ChapResearch/ChapR/ChaprSVN/History/Basic Design (4-9-13).jpg

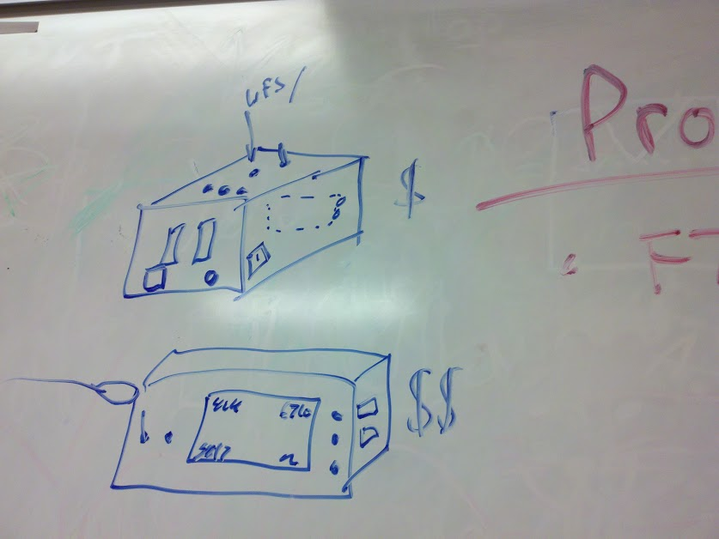
ChaprSVN/History/Basic Design (4-9-13).jpg
