ChapResearch/ChapR/ChaprSVN/Firmware/v1.4 Description.txt

Rachel
	Match mode for FTC
	Match mode for FRC (audio feedback of timing)
	Endgame setting
	Fix autonomous toggling bug (if possible)
	Rewrite FRC packet structure (3 "FF"s)

Coach
	Blinky indication of match mode (out of sync lights)
	Driver database completion (fill in more controller options)
	XBox 360 controller compatibility

*might need to slim down code
