ChapResearch/ChapR/ChaprSVN/Promo/Presentation for FTC.pptx

## The ChapR

Add the kawaii pic from the website

## Slide 2

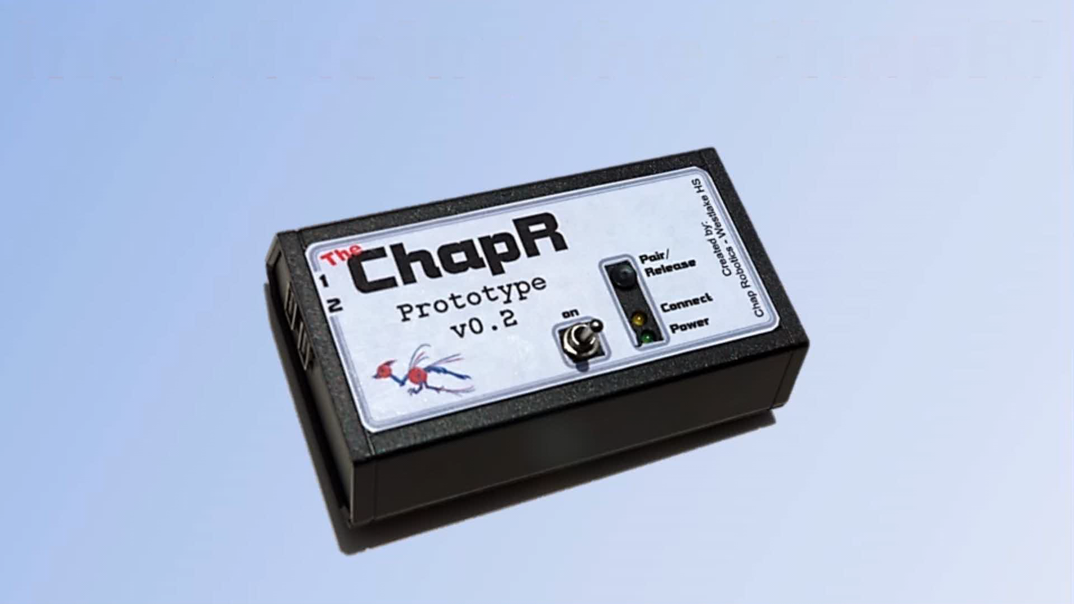
[picture p2: figure]

## Driving

Plug in joysticks

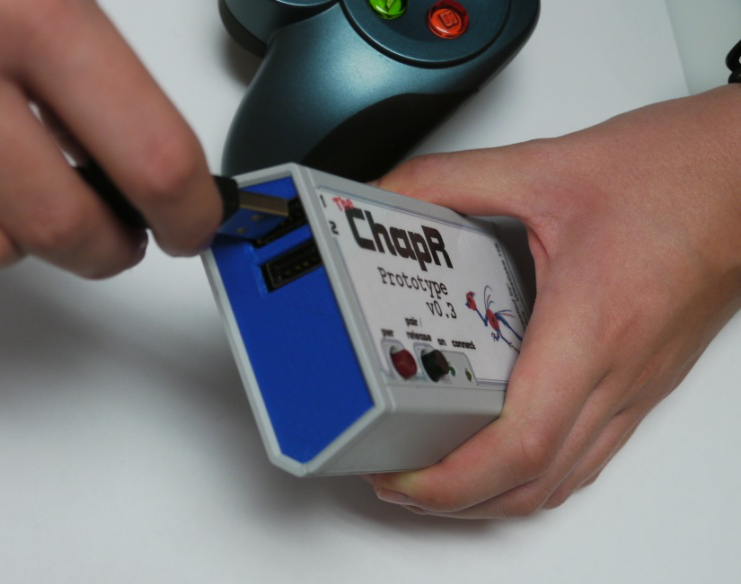
[picture p3: figure]

Hold power button to turn on

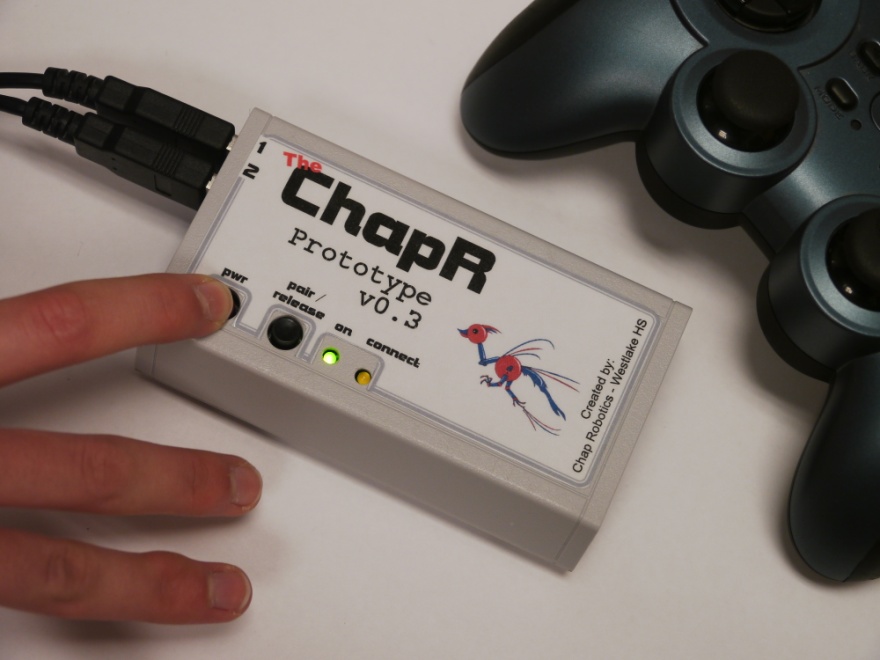
[picture p4: figure]

Hit the WFS button if needed

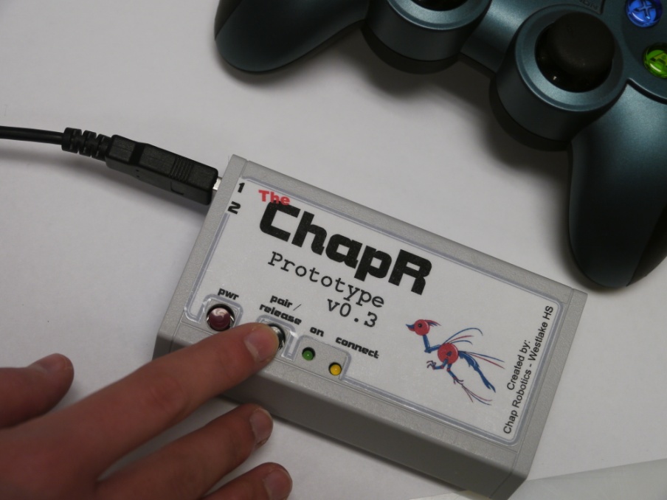
[picture p5: figure]

## The Kill Switch

Tap power button to abort program

TAP

Hold power button to turn off ChapR

HOLD

## Pairing

Via Bluetooth
- Hold down both buttons on the ChapR
- Use NXT menus to find the ChapR and connect with it

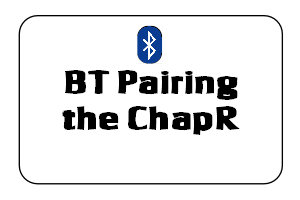
[picture p6: figure]
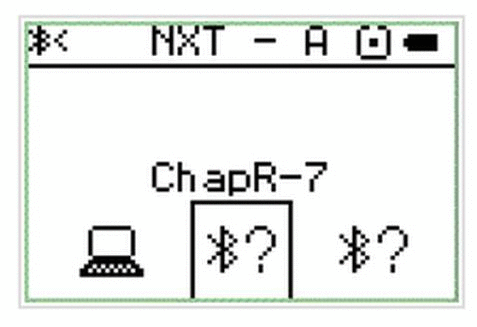
[picture p7: figure]

## Pairing Continued

Via USB
- Make sure Bluetooth is on
- Plug in the cable

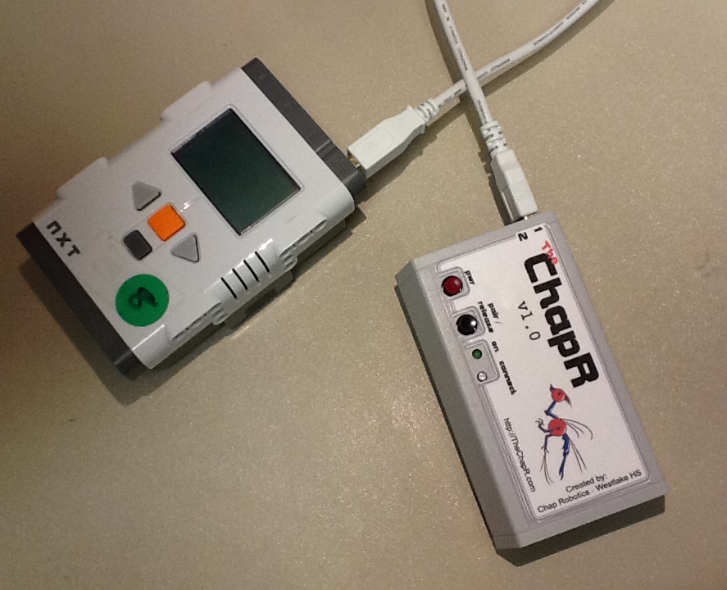
[picture p8: figure]
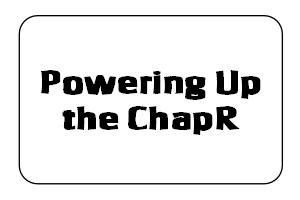
[picture p9: figure]

## Configurable

- name - the name of the ChapR as viewed by devices searching via Bluetooth (usually the NXT); must be under 15 characters; default is ChapR-whichever number ChapR you could (ex: ChapR-14)
- personality - the compatibility of the ChapR; default is 1 (NXT-RobotC); click here to view details
- timeout - the time before the ChapR turns itself off to save battery in minutes; 0 means no timeout; 120 minutes is the maximum; default is 10 minutes
- lag - the time between sending messages; lag can be built in to simulate competition-style driving
- mode - tele-op or autonomous

## Programmable

The programmer and code on our website can be used to reprogram the ChapR

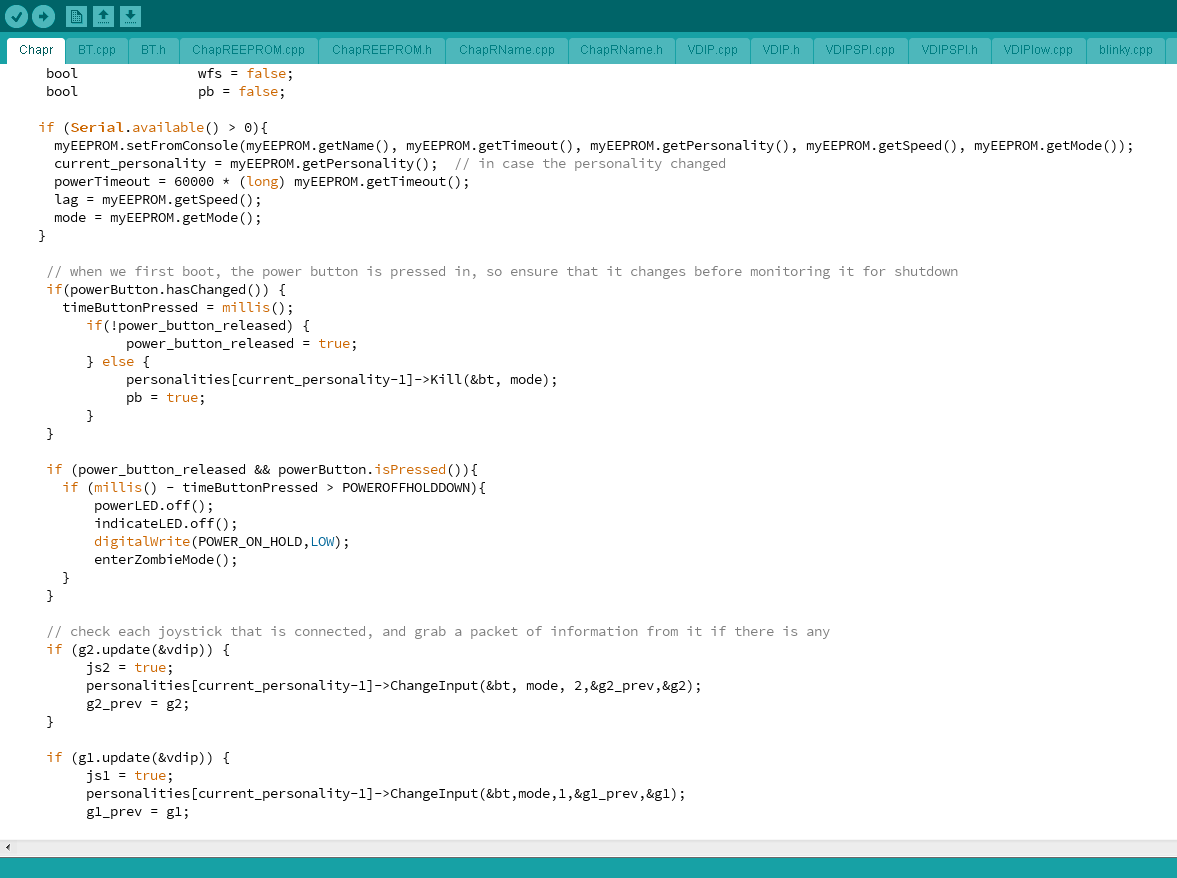
[picture p10: figure]
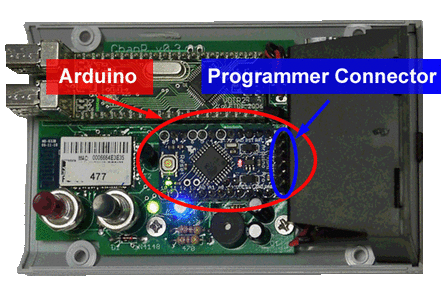
[picture p11: figure]

## The Hardware

USB Interface:
VDIP

Insert flow chart of process and schematic

Arduino Pro-Mini

RN-42

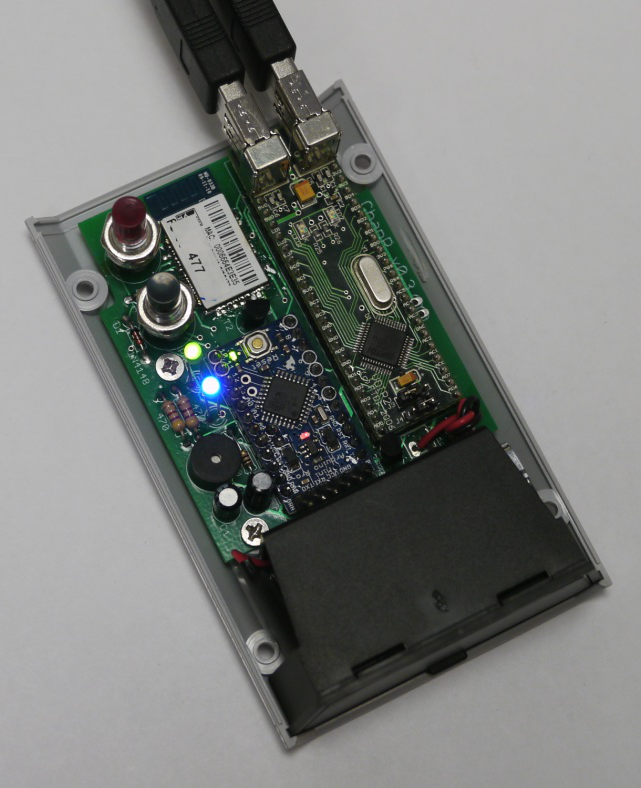
[picture p12: figure]

VDIP

## The Software

- Arduino Sketch written in C

Power Up

Initialize Bluetooth

Set Up

Initialize VDIP

Read EEPROM

## Moving Forward

## Questions? Feedback?

- Any ways to spread the word?
- Advice for manufacturing or production?
- General feedback?
- Uses we didn’t think of?
