ChapResearch/ChapR/ChaprSVN/Case/Labels/Editable Label v2.0.pptx

ChapR

v2.0

action

The

TM

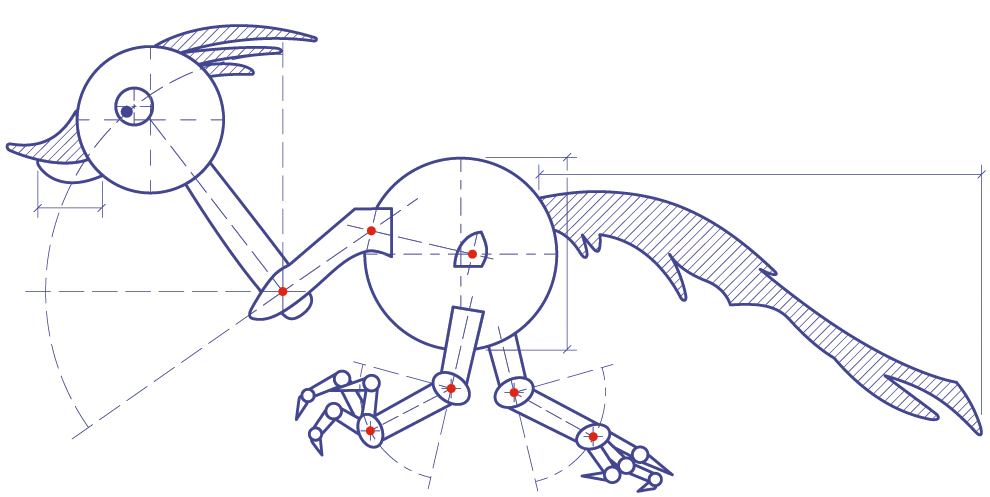
[picture p13: figure]
logo_none_large

http://TheChapR.com

Created by: Chap Research
Patent #9043031

power

on

connect
