ChapResearch/ChapR/ChaprSVN/Firmware/ChapR/Match Cycling Diagram.pptx

Enable match behavior

Power On

Press red button

Kills program

Continues for configured endGame len

Press red button

No Program

Start Auto Program

Press black button

endGame noise

Runs for configured autoLen

Runs for configured teleLen

Tele from FTCConfig.txt starts
