ChapResearch/ChapR/ChaprSVN/PCB/v1.3 Production/Transcode Report.txt

   ---- Transcoding 'C:\Users\Ben\Desktop\Robotics\ChapR\ChapR Code\ChaprSVN\PCB\v1.3 Production\chapr.plc' ----   Mon Aug 18 14:15:53 2014

D10   --> D210
D11   --> D211
D12   --> D212
D13   --> D213
D14   --> D214
D15   --> D215
D16   --> D216
D17   --> D217
D18   --> D218
D19   --> D219
D20   --> D220
D21   --> D221
D22   --> D222
-----------------------------------------------------------------

   ---- Transcoding 'C:\Users\Ben\Desktop\Robotics\ChapR\ChapR Code\ChaprSVN\PCB\v1.3 Production\chapr.sol' ----   Mon Aug 18 14:15:53 2014

D10   --> D223
D11   --> D224
D12   --> D225
D13   --> D226
D14   --> D227
D15   --> D228
D16   --> D229
D17   --> D230
D18   --> D231
D19   --> D232
-----------------------------------------------------------------

   ---- Transcoding 'C:\Users\Ben\Desktop\Robotics\ChapR\ChapR Code\ChaprSVN\PCB\v1.3 Production\chapr.stc' ----   Mon Aug 18 14:15:53 2014

D10   --> D233
D11   --> D234
D12   --> D235
D13   --> D236
D14   --> D237
D15   --> D238
D16   --> D239
D17   --> D240
D18   --> D241
D19   --> D242
D20   --> D243
-----------------------------------------------------------------

   ---- Transcoding 'C:\Users\Ben\Desktop\Robotics\ChapR\ChapR Code\ChaprSVN\PCB\v1.3 Production\chapr.sts' ----   Mon Aug 18 14:15:53 2014

D10   --> D244
D11   --> D245
D12   --> D246
D13   --> D247
D14   --> D248
D15   --> D249
D16   --> D250
D17   --> D251
D18   --> D252
-----------------------------------------------------------------

   ---- Transcoding 'chapr.plc' ----   Mon Aug 18 14:18:10 2014

D10   --> D253
D11   --> D254
D12   --> D255
D13   --> D256
D14   --> D257
D15   --> D258
D16   --> D259
D17   --> D260
D18   --> D261
D19   --> D262
D20   --> D263
D21   --> D264
D22   --> D265
-----------------------------------------------------------------

   ---- Transcoding 'chapr.sol' ----   Mon Aug 18 14:18:10 2014

D10   --> D266
D11   --> D267
D12   --> D268
D13   --> D269
D14   --> D270
D15   --> D271
D16   --> D272
D17   --> D273
D18   --> D274
D19   --> D275
-----------------------------------------------------------------

   ---- Transcoding 'chapr.stc' ----   Mon Aug 18 14:18:10 2014

D10   --> D276
D11   --> D277
D12   --> D278
D13   --> D279
D14   --> D280
D15   --> D281
D16   --> D282
D17   --> D283
D18   --> D284
D19   --> D285
D20   --> D286
-----------------------------------------------------------------

   ---- Transcoding 'chapr.sts' ----   Mon Aug 18 14:18:10 2014

D10   --> D287
D11   --> D288
D12   --> D289
D13   --> D290
D14   --> D291
D15   --> D292
D16   --> D293
D17   --> D294
D18   --> D295
-----------------------------------------------------------------
