ChapResearch/ChapR/ChaprSVN/Case/Labels/Label v2.0 (x8).pdf

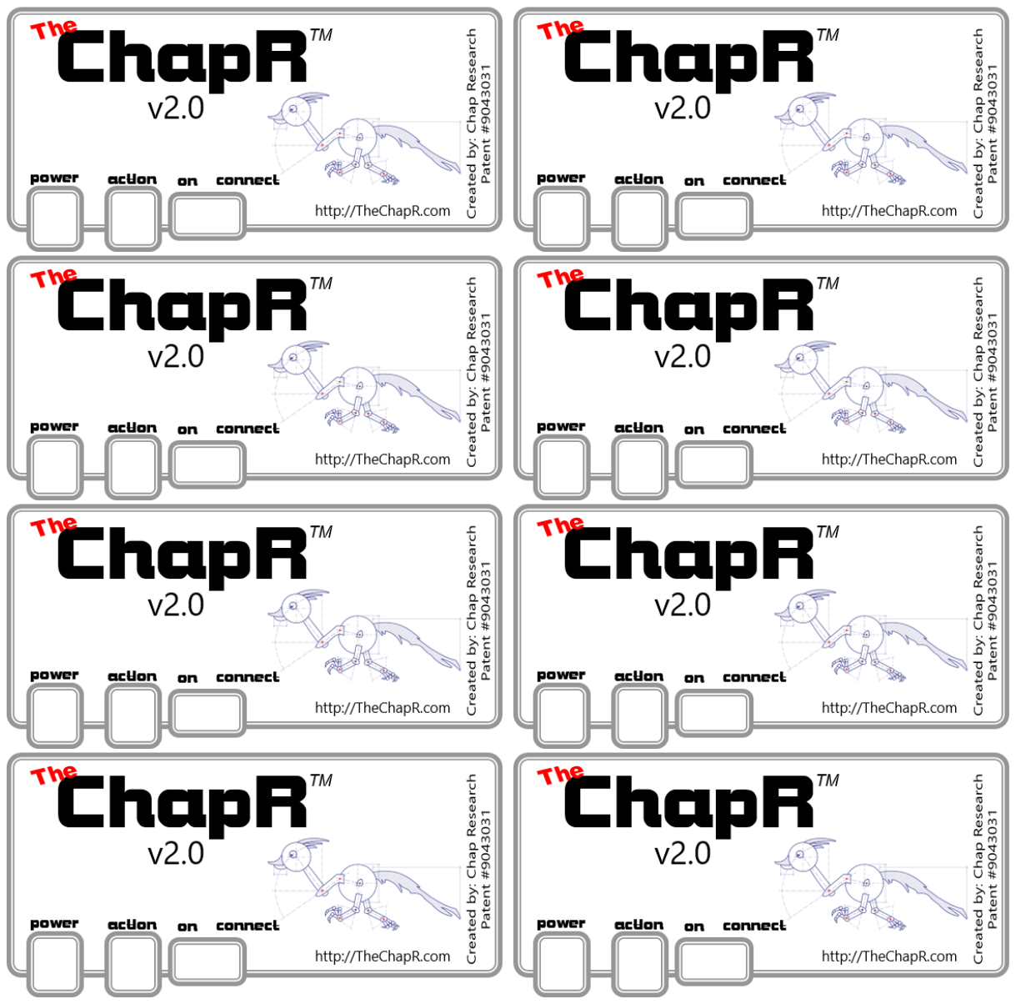
[picture p14: page 1]
