ChapResearch/ChapR/ChaprSVN/PCB/v1.2 Production/Transcode Report.txt

   ---- Transcoding 'C:\Users\Ben\Desktop\Robotics\ChapR\ChapR Code\ChaprSVN\PCB\v1.2 Production\chapr.plc' ----   Tue Mar 18 17:31:22 2014

D10   --> D100
D11   --> D101
D12   --> D102
D13   --> D103
D14   --> D104
D15   --> D105
D16   --> D106
D17   --> D107
D18   --> D108
D19   --> D109
D20   --> D110
D21   --> D111
D22   --> D112
-----------------------------------------------------------------

   ---- Transcoding 'C:\Users\Ben\Desktop\Robotics\ChapR\ChapR Code\ChaprSVN\PCB\v1.2 Production\chapr.sol' ----   Tue Mar 18 17:31:22 2014

D10   --> D113
D11   --> D114
D12   --> D115
D13   --> D116
D14   --> D117
D15   --> D118
D16   --> D119
D17   --> D120
D18   --> D121
D19   --> D122
D20   --> D123
-----------------------------------------------------------------

   ---- Transcoding 'C:\Users\Ben\Desktop\Robotics\ChapR\ChapR Code\ChaprSVN\PCB\v1.2 Production\chapr.stc' ----   Tue Mar 18 17:31:22 2014

D10   --> D124
D11   --> D125
D12   --> D126
D13   --> D127
D14   --> D128
D15   --> D129
D16   --> D130
D17   --> D131
D18   --> D132
D19   --> D133
D20   --> D134
D21   --> D135
-----------------------------------------------------------------

   ---- Transcoding 'C:\Users\Ben\Desktop\Robotics\ChapR\ChapR Code\ChaprSVN\PCB\v1.2 Production\chapr.sts' ----   Tue Mar 18 17:31:22 2014

D10   --> D136
D11   --> D137
D12   --> D138
D13   --> D139
D14   --> D140
D15   --> D141
D16   --> D142
D17   --> D143
D18   --> D144
D19   --> D145
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

D10   --> D124
D11   --> D125
D12   --> D126
D13   --> D127
D14   --> D128
D15   --> D129
D16   --> D130
D17   --> D131
D18   --> D132
D19   --> D133
D20   --> D134
D21   --> D135
-----------------------------------------------------------------

   ---- Transcoding 'C:\Users\Ben\Desktop\Robotics\ChapR\ChapR Code\ChaprSVN\PCB\v1.2 Production\chapr.sts' ----   Tue Mar 18 17:36:02 2014

D10   --> D136
D11   --> D137
D12   --> D138
D13   --> D139
D14   --> D140
D15   --> D141
D16   --> D142
D17   --> D143
D18   --> D144
D19   --> D145
-----------------------------------------------------------------
