ChapResearch/ChapR/ChaprSVN/Case/Labels/Label 2.0.png

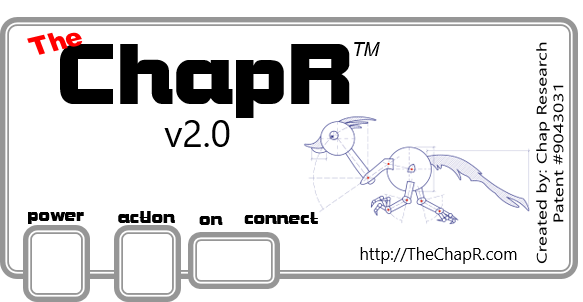
ChaprSVN/Case/Labels/Label 2.0.png
