ChapResearch/ChapR/ChaprSVN/PCB/chapr11-page-001.jpg

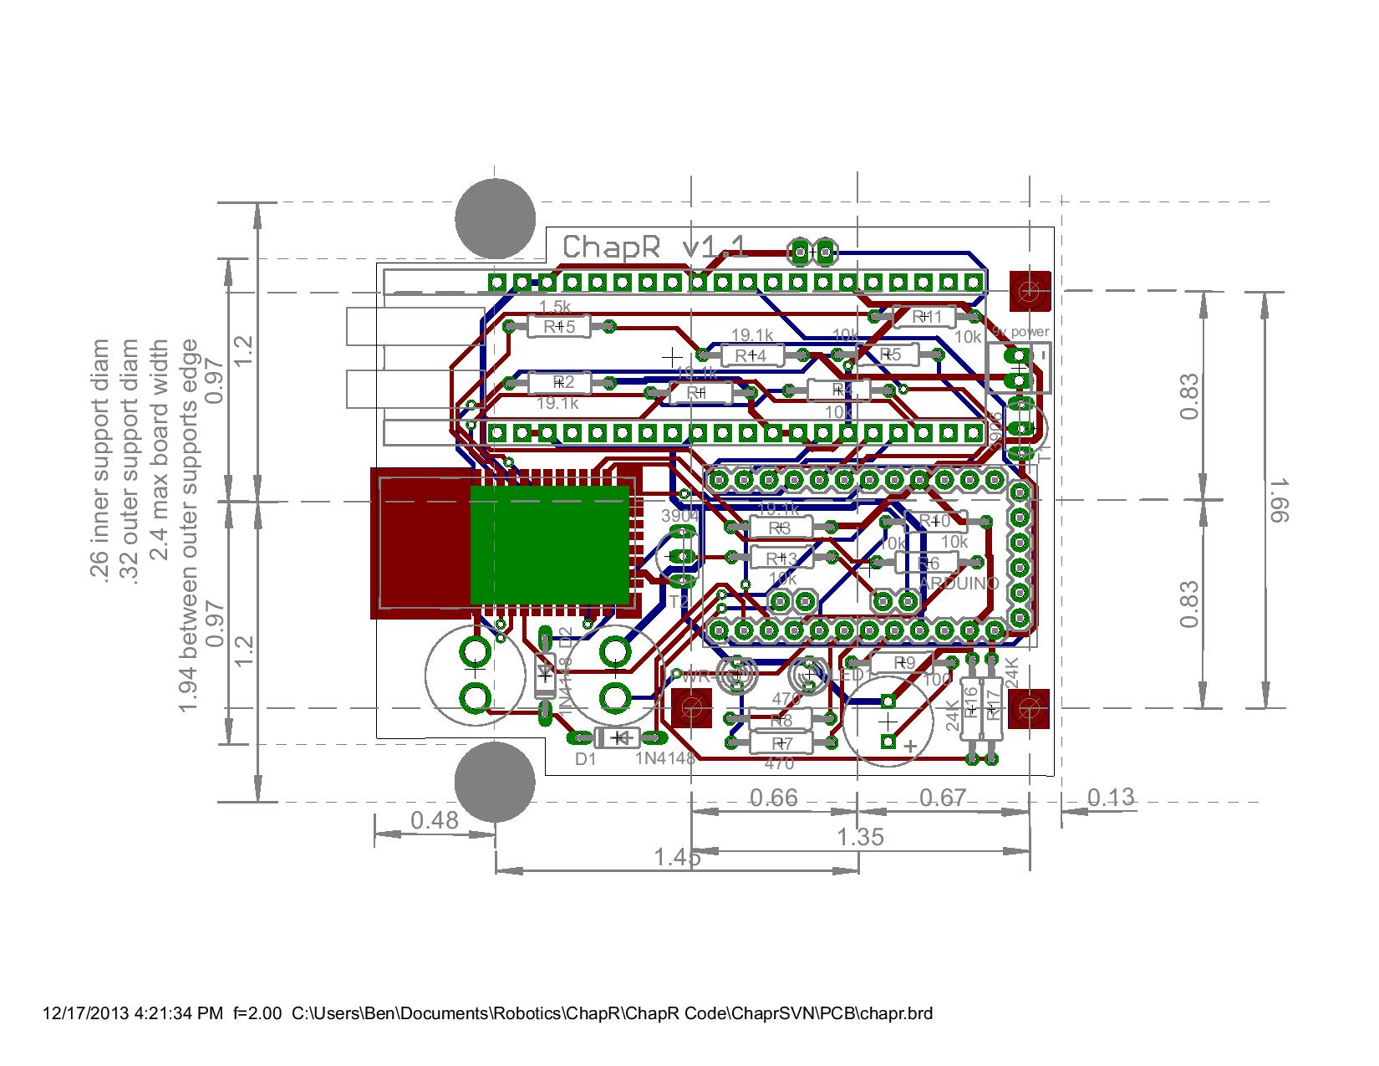
ChaprSVN/PCB/chapr11-page-001.jpg
