ChapResearch/ChapR/ChaprSVN/PCB/chaprsch-page-001.jpg

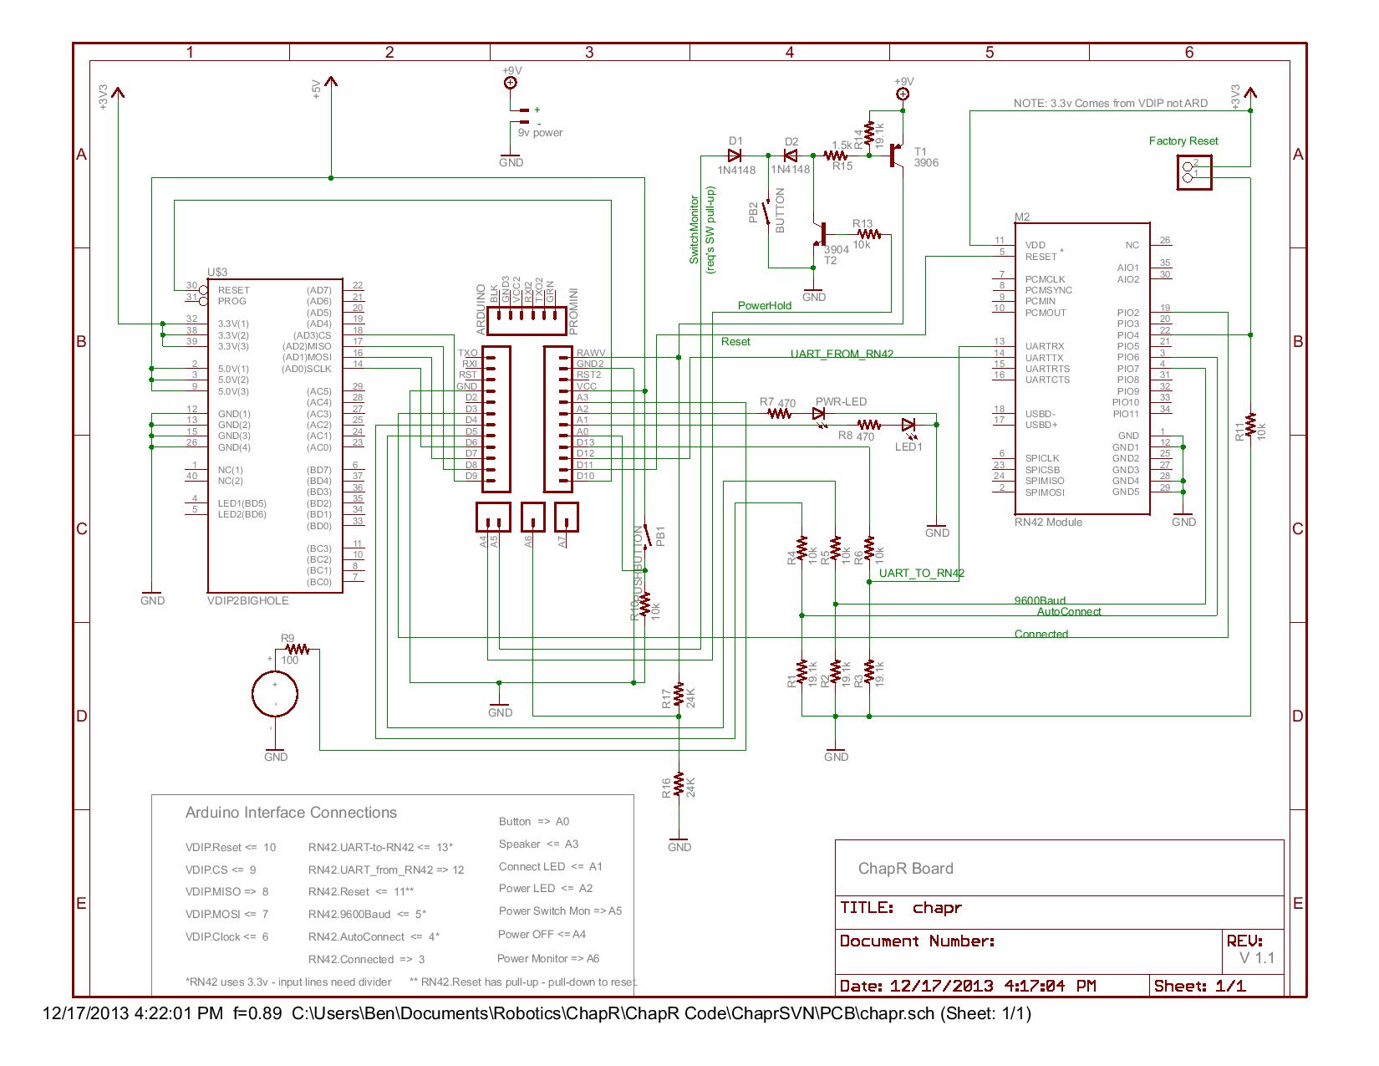
ChaprSVN/PCB/chaprsch-page-001.jpg
