ChapResearch/ChapR/ChaprSVN/History/Inventory.txt

ChapR-5 (1st Button Board)
**needs a lid
yellow and green LEDs
v0.3 board
v1.0 software

ChapR-6 (VHS Board)
**needs to be signed
yellow and green LEDs
v0.3 board
v1.0 software

ChapR-7 (Ben Board)
**has lid with green marks
**battery connector came off
blue and green LEDs
v0.3 board
v1.0 software (w/ board bring-up)

ChapR-8 (Ben Board 2)
**has lid without sticker
**needs to be signed
9V battery connector tied off
blue and green LEDs
v.03 board
v1.0 software (w/ board bring-up)

ChapR-9 (Everybody board)
***NOT WORKING
