ChapResearch/ChapR/ChaprSVN/Reference/ChapR parts list.docx

ChapR parts list

- VDIP2 - $27.05 - http://www.mouser.com/ProductDetail/FTDI/VDIP2/?qs=sGAEpiMZZMtS2C%252bP%252bIdbt5oBzQFVRQxbtDiAvH1hspo%3d
- Roving Networks Bluetooth Module 42 - $15.95 - https://www.sparkfun.com/products/10253
- Arduino MINI - $9.95 - https://www.sparkfun.com/products/11113
- 2 Red LEDs -
- Speaker -
- 9V battery – not included
- Battery connector - $1.13 – https://www.sparkfun.com/products/91
- Solder – not included
- ChapR board - $20 – chapr.weebly.com
- Button – $0.35 - mini push button switch
- 11 resistors – 20 at $0.95 – https://www.sparkfun.com/products/11852
- Switch – $0.45 – https://www.sparkfun.com/products/10727
