ChapResearch/ChapR/ChaprSVN/Manufacturing/PriceSourceList v3 Release.xlsx

QTY | Part Name | Cost | Total | Mouser | Radio Shack | BG Micro | Spark Fun | Digikey | Notes
1 | VDIP2 | $27.05 | $27.05 | 895-VDIP2 |  |  |  | 768-1002-ND
1 | RN42 | 15.95 | $15.95 | 765-RN-42 |  |  | WRL-10253 | 740-1038-ND | - digikey price for 10 matches sparkfun
1 | Arduino Pro MINI | 8.96 | $8.96 |  |  |  | DEV-11113
1 | Green LED | 0.09 | $0.09 | 604-WP710A10PGD
1 | Blue LED | 0.78 | $0.78 | 604-WP710A10MBD
1 | Speaker | 0.30 | $0.30 |  |  | AUD1080
1 | 9V battery - lithium 1200mAh | 6.80 | $6.80 | 5169-U9VL-X |  |  |  |  | - minimum at Mouser is 31 - $6.00 at Battery Junction (+shipping)
1 | 9V battery snap | 0.25 | $0.25 | 121-0426/I-GR |  |  | PRT-00091 |  | - much cheaper at mouser as opposed to spark fun
1 | ChapR board | 7.00 | $7.00 |  |  |  |  |  | - current estimate
1 | Button - red cap | 0.99 | $0.99 | 112-R13-24A-BR
1 | Button - black cap | 0.99 | $0.99 | 112-R13-24A-BB | 275-1547 |  |  |  | - same exact switch - RS is cheaper for singles
4 | 19.1 kΩ resistor | 0.07 | $0.28 | 71-RN55D1912F
7 | 10 kΩ resistor | 0.02 | $0.13 | 291-10K-RC
1 | 100Ω resistor | 0.07 | $0.07 | 291-100-RC
2 | 470Ω resistor | 0.07 | $0.14 | 291-470-RC
2 | 24 kΩ resistor | 0.02 | $0.04 | 291-24k-RC
1 | 1.5 kΩ resistor | 0.02 | $0.02 | 291-1.5k-RC
1 | Case - Serpac A21 (black) | 3.85 | $3.85 | 635-A-21-B |  |  |  | SRA21B-ND
1 | Case - Serpac 9v holder | 0.80 | $0.80 | 635-2006-9V |  |  |  | SRA21-9VBK-ND
1 | 2N3904 transistor | 0.10 | $0.10 | 512-2N3904BU |  |  |  |  | - TO-92 EBC - at 100 quantity, $0.056, bulk
1 | 2N3906 transistor | 0.06 | $0.06 | 512-2N3906BU |  |  |  |  | - TO-92 EBC - at 100 quantity, $0.057, bulk
2 | diode | 0.10 | $0.20 | 583-1N4148-B
1 | misc (headers, label…) | 0.20 | $0.20
3 | screws to hold down board | 0.04 | $0.12 |  |  |  |  |  | - FMW part 1556.440316.188, 4-40 x 3/16 Phillips Pan Machine Screw 18-8 SS
1 | shipping box | 0.55 | $0.55 |  |  |  |  |  | - Office Depot #699328
1 | (opt) cable for NXT | 0.74 | $0.74 | 538-88732-9002 |  |  | CAB-00512 |  | - standard A to B USB cable - monoprice.com
 | (opt) arduino programmer | 14.95 | $0.00 |  |  |  | DEV-09716
 |  |  | $76.46
Notes:
 | - taxes/shipping aren't included in these prices
 | - costs are calculated on a minimum purchase of 10
 | - listed cost is the cheapest of all sources
 | - case price is for the black version - the grey version is $2 cheaper!
 | - costs for transistors/resistors/diodes are based upon purchase of 100
