ChapResearch/ChapR/ChaprSVN/Case/CaseDrillTemplate/template v1.SLDPRT

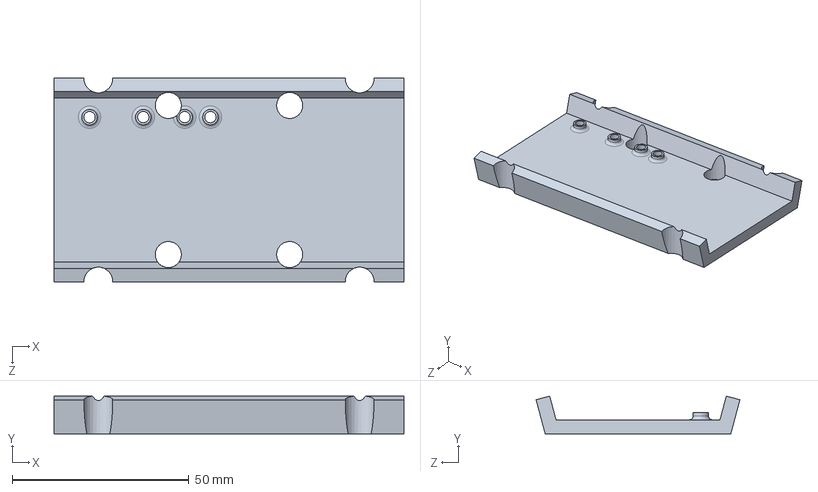
[picture p18: CAD file, 2015-04-01]
ChaprSVN/Case/CaseDrillTemplate/template v1.SLDPRT
99.0 x 10.7 x 57.7 mm
