ChapResearch/ChapR/ChaprSVN/Construction Instructions (for customers).docx

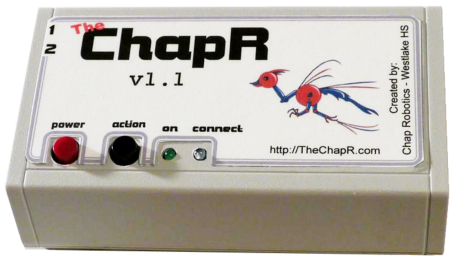
[picture p22: figure]
v1
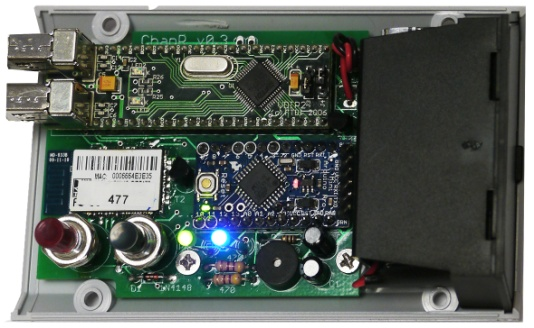
[picture p23: figure]

| ChapR Manufacturing Instructions N S N S v1.3 PCB May 8th, 2014

Name: | | | Date: | | | ChapR #:

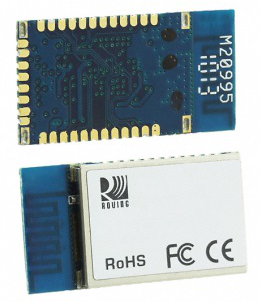
[picture p24: figure]

# 1. PCB – RN-42

Soldering the RN-42 is one of the most key things for creating a ChapR. The pins are VERY close together and need to be lined-up perfectly with the PCB. NOTE: This step has likely already been done for you.

☐ | 1.1. Tin the bottom pads of the RN-42 – wick afterwards to ensure no shorts.
☐ | 1.2. Used double-sided tape on the bottom of the RN-42, so you can position it on the pads on the PCB. Ensure perfect positioning!
☐ | 1.3. Solder one pad to lock-down the RN-42.
☐ | 1.4. Re-inspect for perfect positioning. If not, redo the previous step.
☐ | 1.5. Solder all other pads, using wick if necessary to remove shorts.
☐ | 1.6. After finishing the RN-42, test using voltmeter to find shorts.

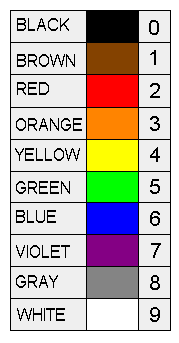
[picture p25: figure]

# 2. PCB – Resistors

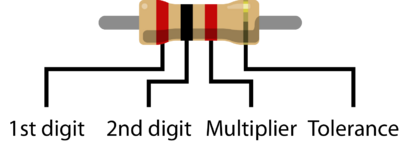
[picture p26: figure]
400px-Resistor_color_code_chart_mod

☐ | 2.1. Place resistors on top of PCB – ensure that they are flat.
☐ | 2.2. Solder from top of board.
☐ | 2.3. Inspect all solder joints.
☐ | 2.4. Clip leads.

# 3. PCB –Diodes

☐ | 3.1. Place diodes on top of PCB – ensure that they are flat and LINED UP correctly. The lines must match the PCB illustration.

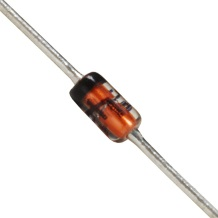
[picture p27: figure]

☐ | 3.2. Solder from top of PCB. Line
☐ | 3.3. Inspect all solder joints.
☐ | 3.4. Clip leads.

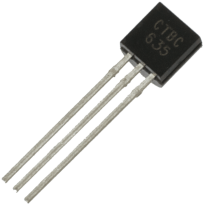
[picture p28: figure]

# 4. PCB – Transistors

3906

3904

☐ | 4.1. Two transistors are mounted from top of PCB – note positioning of 3906 and 3904. Insert as indicated on the PCB and press down to position about ¼ inch above PCB.
☐ | 4.2. Bend one pin at the bottom of PCB to keep in place and solder from bottom, the other two pins.
☐ | 4.3. Un-bend the other pin and solder it.
☐ | 4.4. Inspect all solder joints.
☐ | 4.5. Clip leads.

# 5. PCB – Arduino Preparation

The Arduino is first “prepared” before it is soldered. This consists of soldering the pins to the Arduino board but NOT soldering it to the PCB yet. The PCB is used, however, as the line-up mechanism for the pins for the Arduino board.

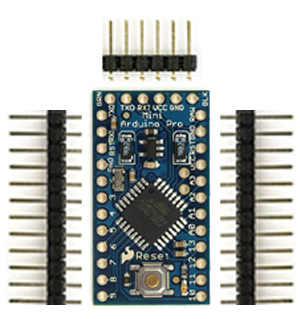
[picture p29: figure]

☐ | 5.1. Place two 12-pin headers on PCB in appropriate positions for Arduino with the long pins of the header in the PCB.

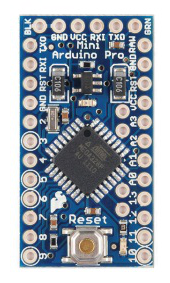
[picture p30: figure]

☐ | 5.2. Place two 2-pin header in the positions marked XXXXX on the PCB with the long pins of the header in the PCB. This matches the two holes on the Arduino close to VCC/A3/A2.
☐ | 5.3. Orient and place the Arduino, face up, on top of the pins and solder all headers to the Arduino.
☐ | 5.4. Inspect all solder joints.
☐ | 5.5. Remove Arduino from PCB and insert 6-pin header ON TOP of Arduino – the short pins of the header go into the Arduino board.
☐ | 5.6. Place Arduino upside-down on table, allowing 6-pin header to flare outwards. Solder the 6-pin header from the bottom of the Arduino.

# 6. PCB – Arduino Installation

☐ | 6.1. Place the prepared Arduino on the PCB, pushing it down onto the board as flush as possible.
☐ | 6.2. While holding the Arduino flush, solder two opposite corner pins on the Arduino from the bottom of the PCB – to keep it flush.
☐ | 6.3. Solder all remaining pins.
☐ | 6.4. Inspect all solder joints.

# 7. PCB – VDIP

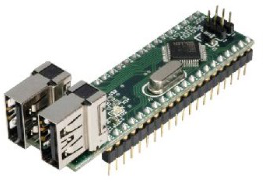
[picture p31: figure]

☐ | 7.1. Insert the VDIP into the PCB. Top Jumper
☐ | 7.2. While holding the VDIP as flush as possible to the PCB, bend down two corner pins under the PCB to lock the VDIP in place. Then ensure that it is flush to the PCB.
☐ | 7.3. Solder all remaining other (non-bent) pins.
☐ | 7.4. Unbend and solder the two corner pins.
☐ | 7.5. Inspect all solder joints.
☐ | 7.6. Move the top jumper to the other two pins.

# 8. PCB – Buttons

☐ | 8.1. Mount the power button (red) and bend the flanges to be flush with the bottom of the PCB (placement direction doesn’t matter).
☐ | 8.2. Solder the button to the PCB using a significant amount of solder
☐ | 8.3. Mount the action button (black) and bend the flanges to be flush with the bottom of the PCB (placement direction doesn’t matter).
☐ | 8.4. Solder the button to the PCB using a significant amount of solder.

# 9. PCB – Speaker

☐ | 9.1. Check the backside of the speaker for the plus sign and line it up with the plus sign on the board.
☐ | 9.2. Bend one pin on the back to hold it in place and solder the other pin from the bottom.
☐ | 9.3. Bend the pin back and solder, clip.

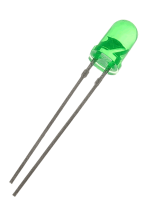
[picture p32: figure]

# 10. PCB – LEDs

Short
Node

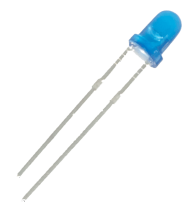
[picture p33: figure]

Identify the long lead of each LED – this is the positive lead. If the LED leads have been cut, the long lead side can be determined by finding the short node inside the LED.

Long Lead

☐ | 10.1. Starting with the green LED, insert it next to the black button with the positive side South (long lead). Line up the top of the LED to the top of the black button when pressed, and bend the long lead so that the LED hangs at the right height when the PCB is upside down. Solder the short lead.
☐ | 10.2. Unbend the long lead and go back to the top side of the PCB and ensure that the LED is aligned to the center of the buttons.
☐ | 10.3. Solder the long lead.
☐ | 10.4. Insert the blue LED with the long lead South, bending the long lead to allow the blue LED to hang at the same height as the green LED. Solder the short lead.
☐ | 10.5. Unbend the long lead and go back to the top side of the PCB and ensure that the LED is aligned to the center of the buttons.
☐ | 10.6. Solder the long lead.
☐ | 10.7. Clip leads

# 11. PCB – 9V Snap

☐ | 11.1. Tin the wires to stiffen them.
☐ | 11.2. Insert and bend opposite ways. BLACK IS NEGATIVE.
☐ | 11.3. Solder to board, making sure that black is lined up with minus sign and it sticks up above the board.

May 8th, 2014 ChapR Manufacturing Instructions Page 1 of 4 v1.3 PCB
