ChapResearch/ChapR/ChaprSVN/History/FCS Operations (4-12-13).docx

FCS Operations

1. All 3 rBricks on and connected to their respective ChapRs
2. Connect your rBrick to the ChapFCS (same way as ChapR)
3. LCD says “Connect to other ChapRs”
4. ChapRs hold down the button to make their ChapRs discoverable
5. ChapFCS selects ChapRs on LCD screen
