ChapResearch/ChapR/ChaprSVN/Test Data/LagResearch v1.xlsx

180 | 1 joystick plugged in |  |  | no stick activity
lag | count | notes | per sec | delay ms
0 | 8292 |  | 46.1 | 21.70767004
10 | 5680 |  | 31.6 | 31.69014085
25 | 3860 |  | 21.4 | 46.63212435
50 | 2516 |  | 14.0 | 71.54213037
100 | 1481 |  | 8.2 | 121.5395003
150 | 1049 |  | 5.8 | 171.5919924
200 | 814 |  | 4.5 | 221.1302211
250 | 664.2066421 |  | 3.7 | 271 | extrapolated
