ChapResearch/ChapR/ChaprSVN/Test Data/lagGraph.png

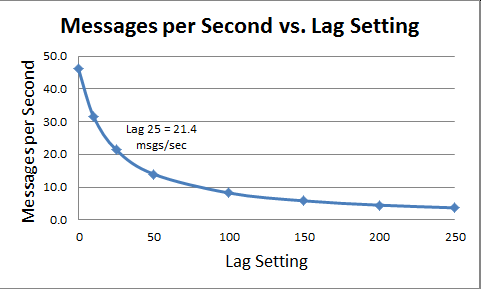
ChaprSVN/Test Data/lagGraph.png
