ChapResearch/ChapR/ChaprSVN/History/Website Progress.docx

Questionable Changes to the Website

- Took out the pages under “Get Started!” and replaced them with ChapR and ChapFCS

ChapFCS Stuff to be Added Later

- Pictures under the picture gallery
- FAQS Questions on the added functionality of the ChapFCS such as setting up a match, adding the lag, running autonomous etc.
  - How do I set up a match?
  - How do I kick someone out of a match?
  - How do I add the lag to our match?
- Repairs
- Updates
- Buy It

The full ChapR model, the ChapFCS has all the features you need to simulate the field at competition:

- Toggled lag feature (lag simulates the poor wi-fi connection at competitions)
- Simulates the Field Control System (one robot on ChapR model, up to three on ChapRs linked to the ChapFCS)
- Displays connected teams on the LCD
- All the features included in the ChapR

Assignment 1

Upon boot it prompts the user to hit return if you want to rename it

Prints current name “ChapR-new”

Accepts a String from the user followed by a return and sets the name

Can be anything except ChapR-1

Requests a yes or no to confirm

If no, return

If yes, reboot

eeprom
