ChapResearch/ChapR/ChaprSVN/PCB/chapr11.pdf

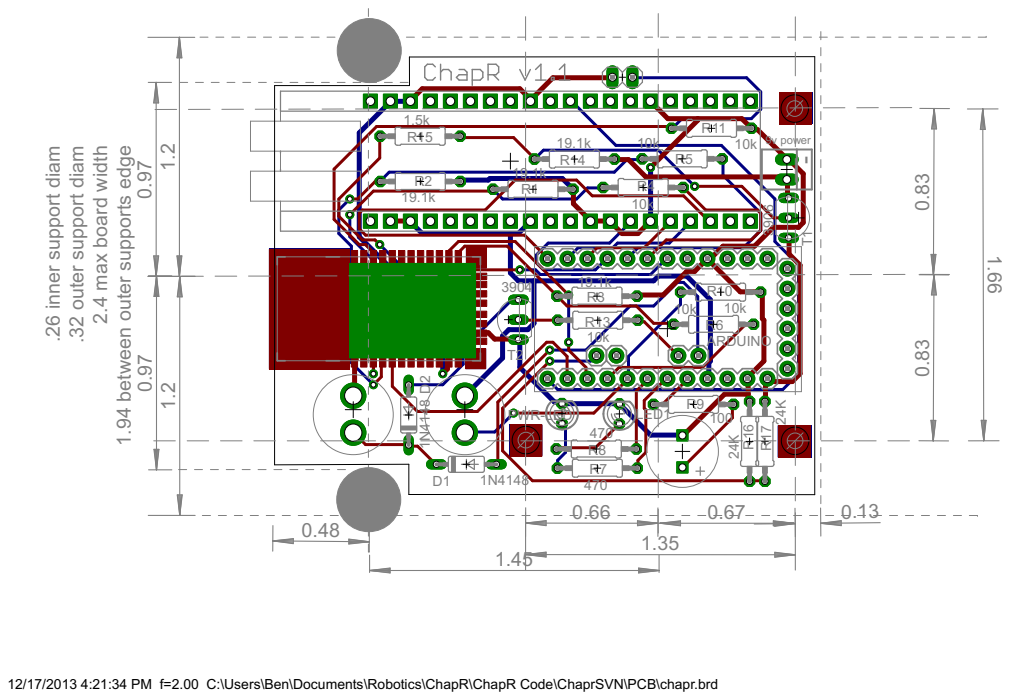
[picture p35: page 1]

12/17/2013 4:21:34 PM f=2.00 C:\Users\Ben\Documents\Robotics\ChapR\ChapR Code\ChaprSVN\PCB\chapr.brd
