ChapResearch/ChapR/ChaprSVN/PCB/chaprsch.pdf

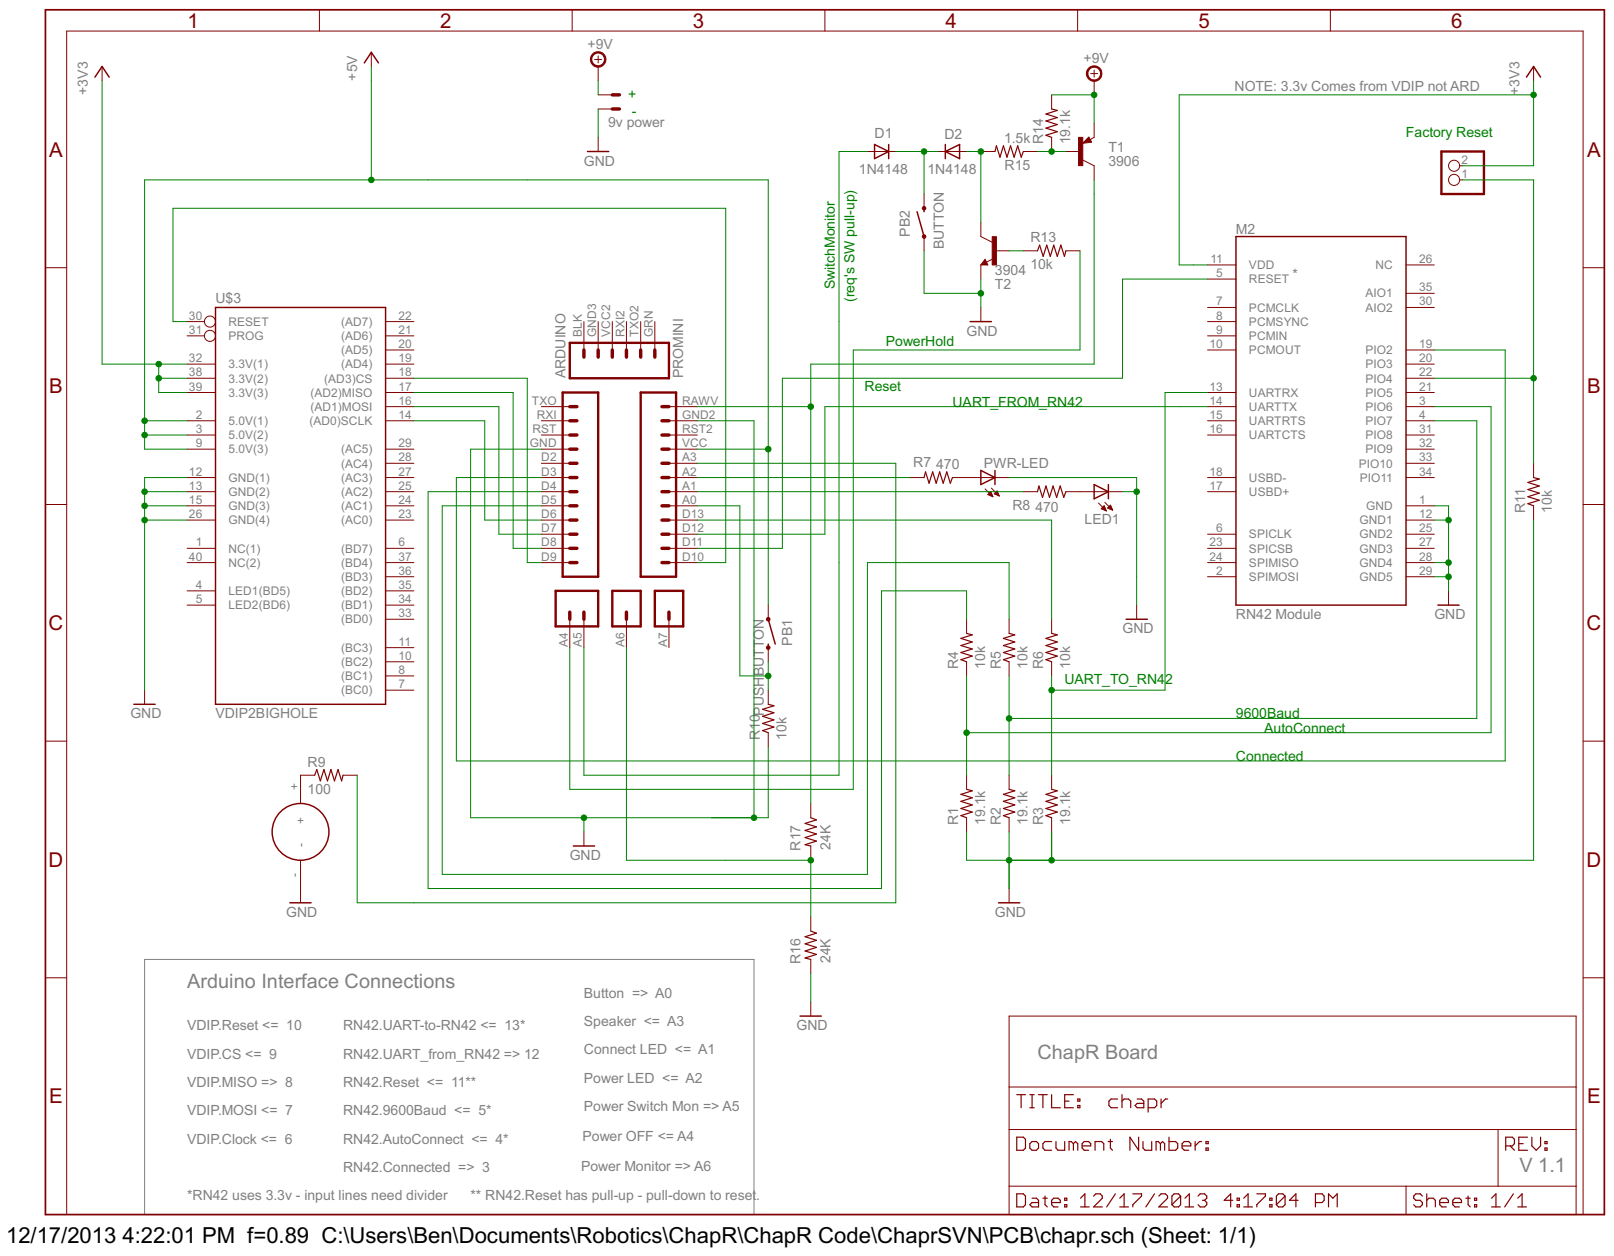
[picture p36: page 1]

NOTE: 3.3v Comes from VDIP not ARD

(req's SW pull-up)
PowerHold SwitchMonitor

12/17/2013 4:22:01 PM f=0.89 C:\Users\Ben\Documents\Robotics\ChapR\ChapR Code\ChaprSVN\PCB\chapr.sch (Sheet: 1/1)
