ChapResearch/ChapR/ChaprSVN/PCB/chapr.brd

## EAGLE design ChaprSVN/PCB/chapr.brd (2014-09-29)

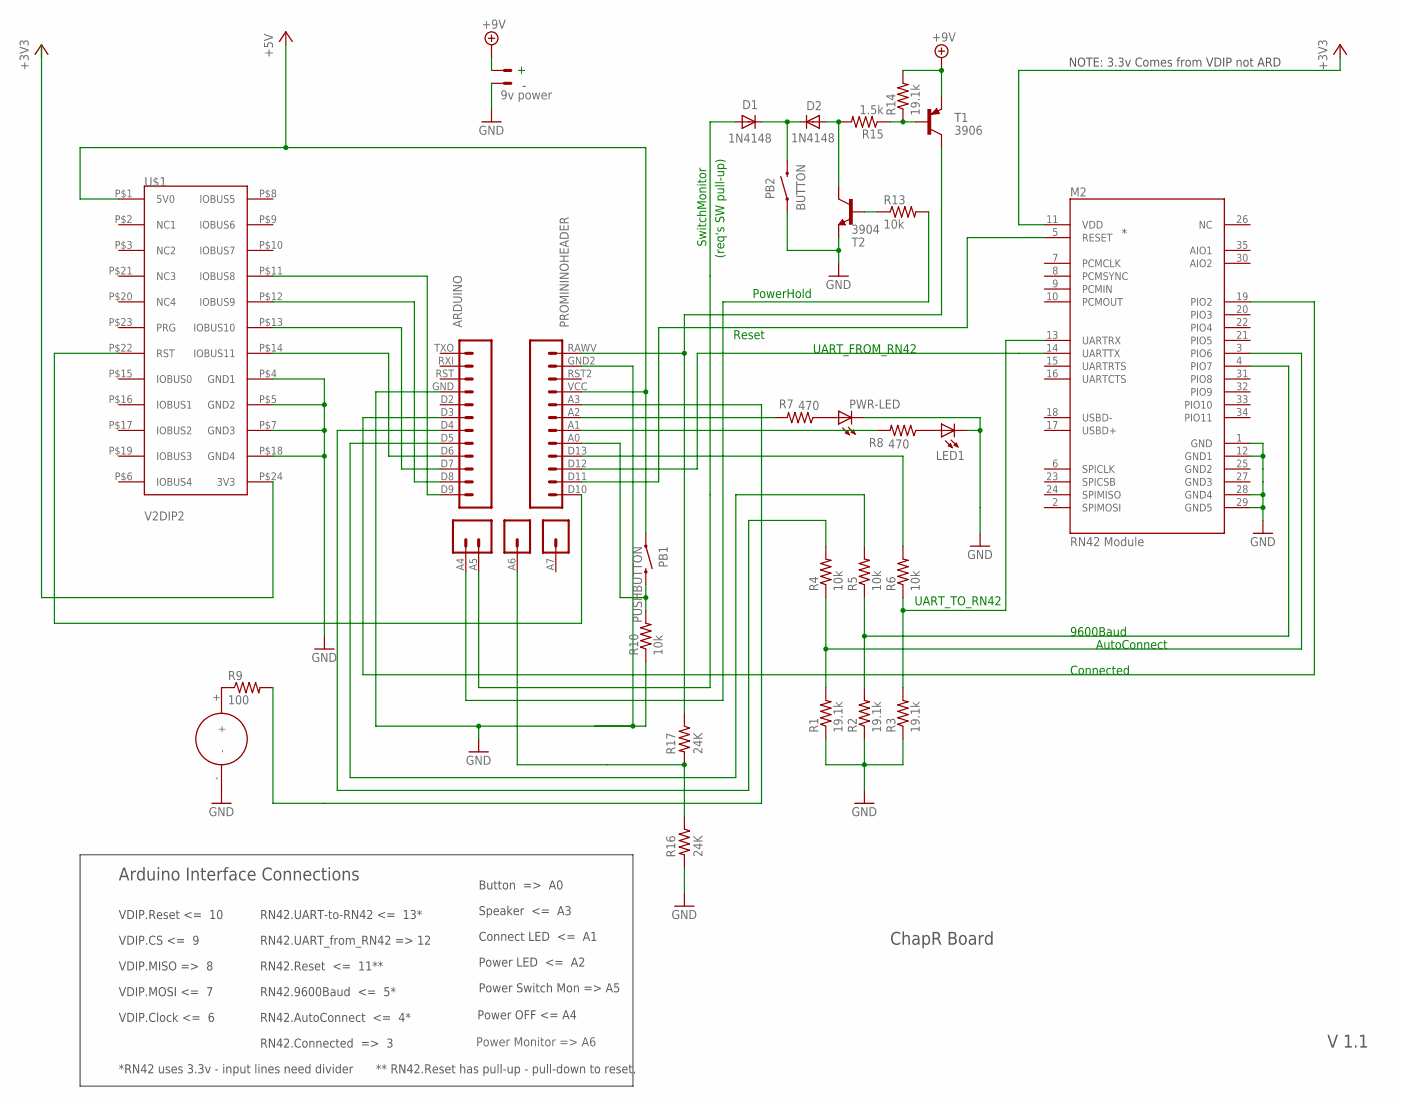
[picture p37: schematic chapr.sch]

Parts:
-: 9v power; 22-23-2021
ARDUINO: PROMININOHEADER
D1, D2: 1N4148; DO35-7
LED1: LED3MM
M2: RN42 Module; RN41
PB1: PUSHBUTTON; 2-PIN-PUSHBUTTON
PB2: BUTTON; 2-PIN-PUSHBUTTON
PWR-LED: LED3MM
R1, R2, R3, R14: 19.1k; 0207/10
R4, R5, R6, R10, R13: 10k; 0207/10
R7, R8: 470; 0207/10
R9: 100; 0207/10
R15: 1.5k; 0207/10
R16, R17: 24K; 0207/10
T1: 3906; TO92-EBC
T2: 3904; TO92-EBC
U$1: V2DIP2
U$2: SPEAKER

Connections:
+3V3: M2.11 (VDD), U$1.P$24 (3V3)
+5V: ARDUINO.VCC, PB1.P$1 (1), U$1.P$1 (5V0)
+9V: -.2, R14.2, T1.E
GND: -.1, ARDUINO.GND, ARDUINO.GND2, LED1.K (C), M2.1 (GND), M2.12 (GND1), M2.28 (GND4), M2.29 (GND5), PB2.P$1 (1), PWR-LED.K (C), R1.1, R2.1, R3.1, R10.1, R16.2, T2.E, U$1.P$4 (GND1), U$1.P$5 (GND2), U$1.P$7 (GND3), U$1.P$18 (GND4), U$2.-
unnamed: R14.1, R15.1, T1.B
unnamed: ARDUINO.D10, U$1.P$22 (RST)
unnamed: ARDUINO.D13, R6.2
unnamed: ARDUINO.D12, M2.14 (UARTTX)
unnamed: ARDUINO.D11, M2.5 (RESET)
unnamed: M2.3 (PIO6), R1.2, R4.1
unnamed: M2.4 (PIO7), R2.2, R5.1
unnamed: ARDUINO.D5, R5.2
unnamed: M2.13 (UARTRX), R3.2, R6.1
unnamed: ARDUINO.D6, U$1.P$14 (IOBUS11)
unnamed: ARDUINO.D7, U$1.P$13 (IOBUS10)
unnamed: ARDUINO.D8, U$1.P$12 (IOBUS9)
unnamed: ARDUINO.D9, U$1.P$11 (IOBUS8)
unnamed: ARDUINO.D4, R4.2
unnamed: ARDUINO.D3, M2.19 (PIO2)
unnamed: PWR-LED.A, R7.1
unnamed: LED1.A, R8.1
unnamed: ARDUINO.A2, R7.2
unnamed: R9.1, U$2.+
unnamed: ARDUINO.A1, R8.2
unnamed: ARDUINO.A3, R9.2
unnamed: ARDUINO.RAWV, R17.1, T1.C
unnamed: ARDUINO.A0, PB1.P$2 (2), R10.2
unnamed: D2.A, R15.2, T2.C
unnamed: R13.1, T2.B
unnamed: D1.C, D2.C, PB2.P$2 (2)
unnamed: ARDUINO.A5, D1.A
unnamed: ARDUINO.A4, R13.2
unnamed: ARDUINO.A6, R16.1, R17.2

Notes on the sheet:
9600Baud
AutoConnect
UART_TO_RN42
UART_FROM_RN42
Reset
Arduino Interface Connections
VDIP.Reset <= 10
VDIP.Clock <= 6
VDIP.CS <= 9
VDIP.MOSI <= 7
VDIP.MISO => 8
RN42.UART-to-RN42 <= 13*
RN42.UART_from_RN42 => 12
RN42.Reset <= 11**
RN42.9600Baud <= 5*
RN42.AutoConnect <= 4*
RN42.Connected => 3
*RN42 uses 3.3v - input lines need divider
** RN42.Reset has pull-up - pull-down to reset.
NOTE: 3.3v Comes from VDIP not ARD
V 1.1
ChapR Board
Button => A0
Speaker <= A3
Connect LED <= A1
Power LED <= A2
Connected
PowerHold
SwitchMonitor
Power Switch Mon => A5
Power OFF <= A4
(req's SW pull-up)
Power Monitor => A6

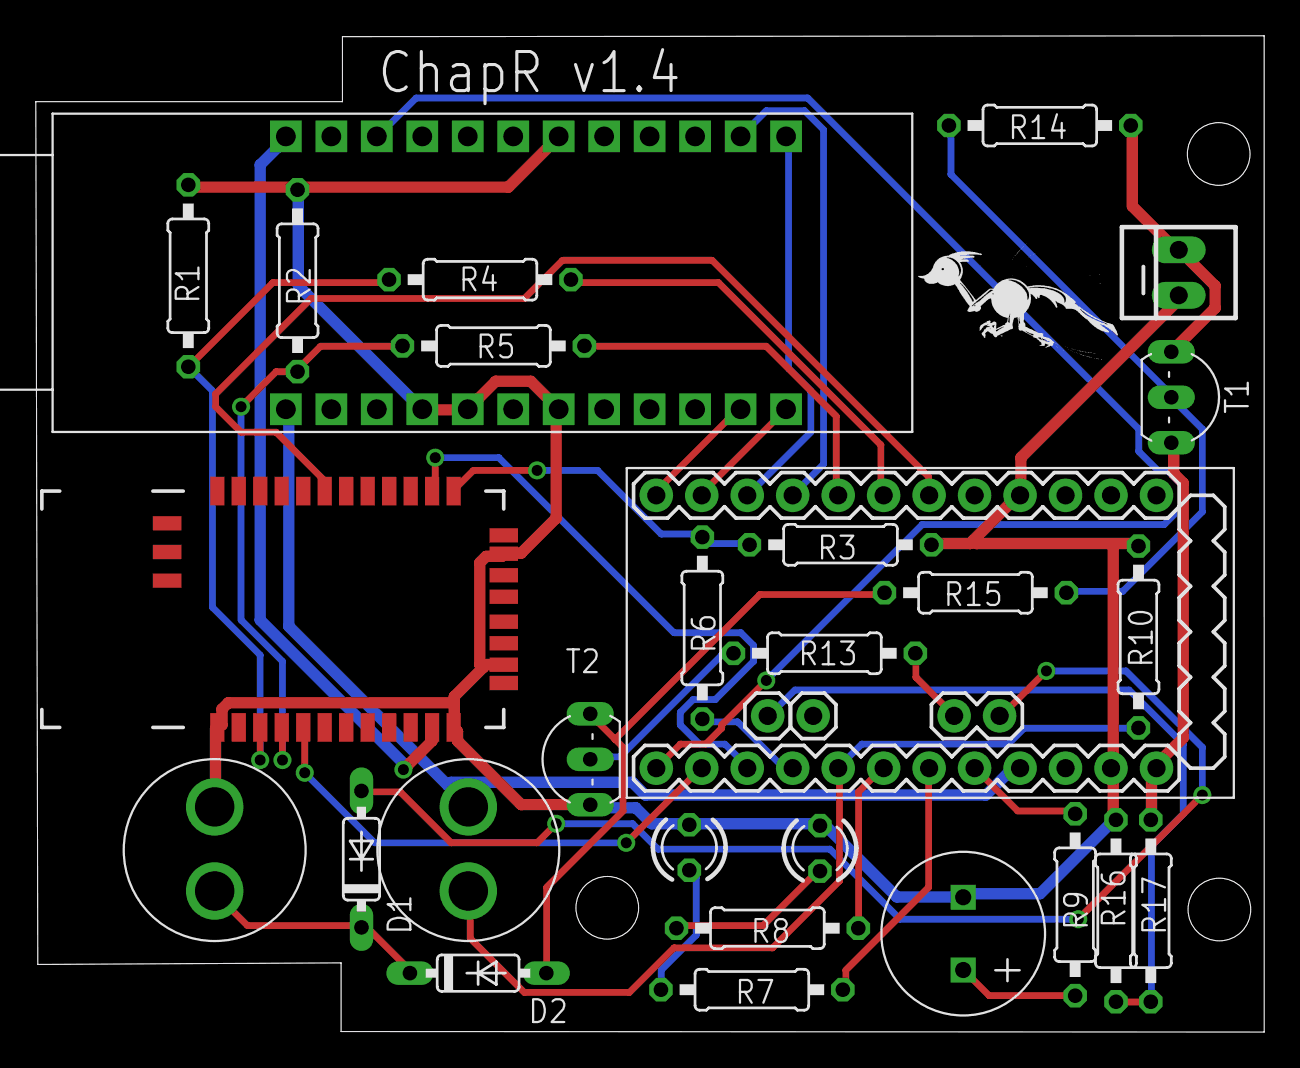
[picture p38: board chapr.brd from above]

Board: 2 copper layers, 68.6 x 55.6 mm, 28 parts (0 on the bottom side), 33 nets.
