ChapResearch/ChapR/ChaprSVN/PCB/Examples/ProtoShield-v25.brd

## EAGLE design ChaprSVN/PCB/Examples/ProtoShield-v25.brd (2013-04-17)

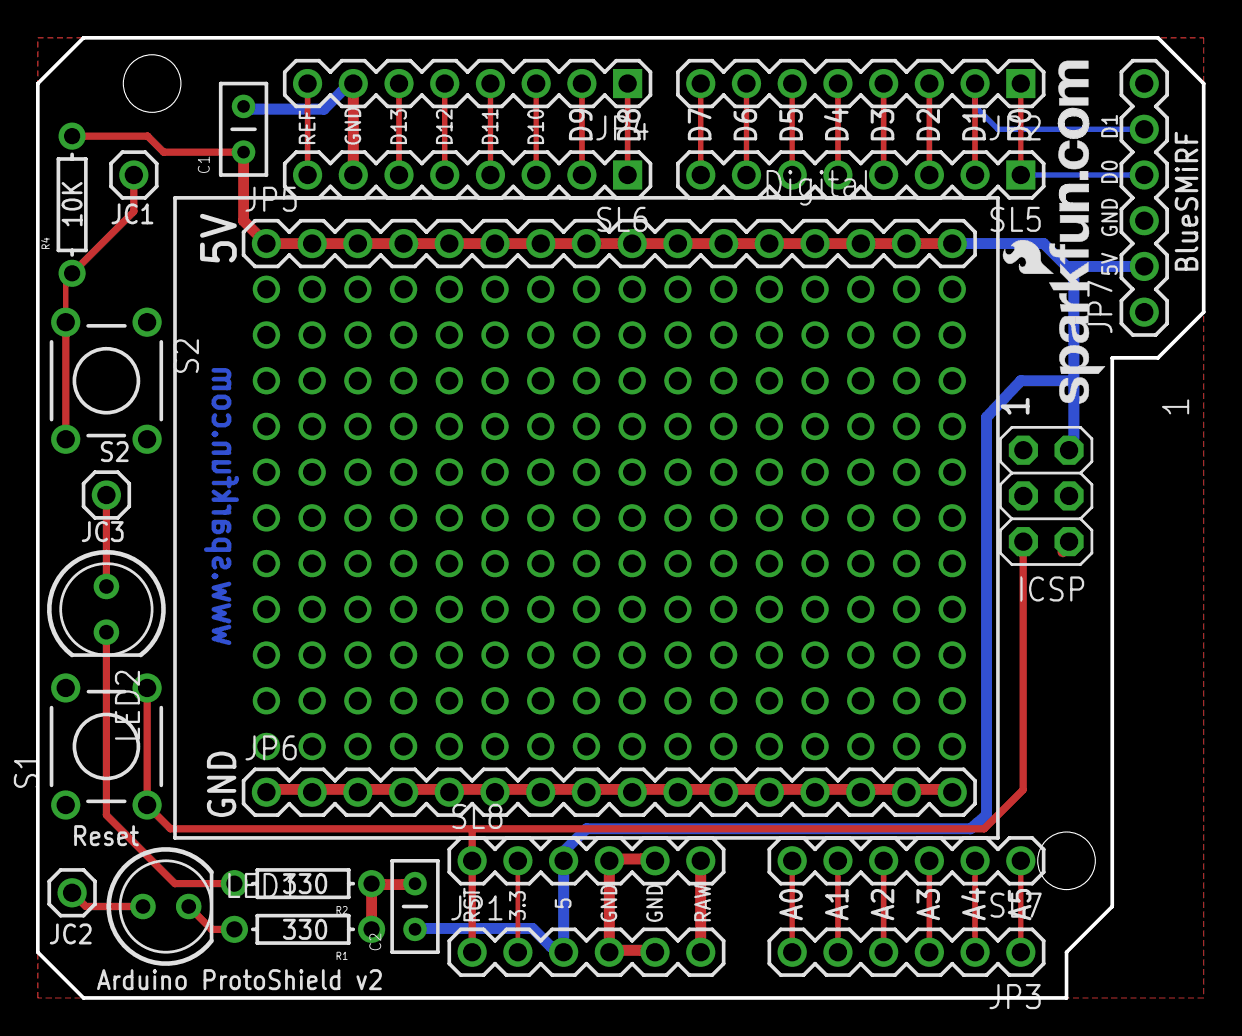
[picture p39: board ProtoShield-v25.brd from above]

Board: 2 copper layers, 64.8 x 53.3 mm, 27 parts (0 on the bottom side), 31 nets.

Parts:
BB1: BREADBOARDMINI; BREADBOARD-MINI
C1, C2: 0.1uF; CAP-PTH-SMALL2
ICSP: ICSP; 2X03
JC1, JC2, JC3: M01PTH; 1X01
JP1: Power; 1X06
JP2: Digital1; 1X08
JP3: Analog; 1X06
JP4: Digital2; 1X08
JP5, JP6: M16PTH; 1X16
JP7: BlueSMiRF; 1X06
LED1, LED2: LED5MM
R1, R2: 330; AXIAL-0.3
R4: 10K; AXIAL-0.3
S1: Reset; TACTILE-PTH
S2: TACTILE-PTH
SL5, SL6: 1X08
SL7, SL8: 1X06
U$1: LOGO-SFENEW; SFE-NEW-WEBLOGO
U$2: CREATIVE_COMMONS

Connections:
3.3V: JP1.2, SL8.2
5V: C1.1, C2.1, ICSP.2, JP1.3, JP5.1, JP5.2, JP5.3, JP5.4, JP5.5, JP5.6, JP5.7, JP5.8, JP5.9, JP5.10, JP5.11, JP5.12, JP5.13, JP5.14, JP5.15, JP5.16, JP7.2, R4.P$2, SL8.3
A0: JP3.6, SL7.6
A1: JP3.5, SL7.5
A2: JP3.4, SL7.4
A3: JP3.3, SL7.3
A4: JP3.2, SL7.2
A5: JP3.1, SL7.1
AREF: JP4.8, SL6.8
D2: JP2.3, SL5.3
D3: JP2.4, SL5.4
D4: JP2.5, SL5.5
D5: JP2.6, SL5.6
D6: JP2.7, SL5.7
D7: JP2.8, SL5.8
D8: JP4.1, SL6.1
D9: JP4.2, SL6.2
D10: JP4.3, SL6.3
D11: JP4.4, SL6.4
D12: JP4.5, SL6.5
D13: JP4.6, SL6.6
GND: C1.2, C2.2, ICSP.6, JP1.4, JP1.5, JP4.7, JP6.1, JP6.2, JP6.3, JP6.4, JP6.5, JP6.6, JP6.7, JP6.8, JP6.9, JP6.10, JP6.11, JP6.12, JP6.13, JP6.14, JP6.15, JP6.16, JP7.3, R1.P$1, R2.P$1, S1.1, S1.2, S2.1, S2.2, SL6.7, SL8.4, SL8.5
unnamed: JC1.1, R4.P$1, S2.3, S2.4
unnamed: LED1.K, R1.P$2
unnamed: LED2.K, R2.P$2
unnamed: JC2.1, LED1.A
unnamed: JC3.1, LED2.A
RESET: ICSP.5, JP1.1, S1.3, S1.4, SL8.1
RX: JP2.1, JP7.4, SL5.1
TX: JP2.2, JP7.5, SL5.2
VIN: JP1.6, SL8.6
