ChapResearch/ChapR/ChaprSVN/Firmware/ChapR/config.h

//
// config.h
//
//   Configuration for the ChapR board
//
// there were two different major versions of the board, with two different
// pin assignments.  we are using v02 now.  V01 is around for reference for
// the old board.

#define V02


#ifdef V01

#define BT_9600BAUD 	A5
#define BT_CONNECTED	A4
#define BT_MODE		A3
#define BT_RX		12
#define BT_TX		13
#define BT_RESET	11

#define VDIP_CLOCK	6
#define VDIP_MOSI	7
#define VDIP_MISO	8
#define VDIP_CS		9
#define VDIP_RESET	10

#define LED_POWER	A2
#define LED_INDICATE	A1

#define BUTTON		A0
#define TONEPIN		5

#endif

#ifdef V02

#define BT_9600BAUD 	5		// (==>BT) forces BT module to 9600 baud mode
#define BT_CONNECTED	3		// (<==BT) BT module asserts when connect to BT
#define BT_MODE		4		// (==>BT) sets the auto connect mode
#define BT_RX		12
#define BT_TX		13
#define BT_RESET	11

#define VDIP_CLOCK	6
#define VDIP_MOSI	7
#define VDIP_MISO	8
#define VDIP_CS		9
#define VDIP_RESET	10

#define LED_POWER	A2
#define LED_INDICATE	A1

#define BUTTON		A0
#define TONEPIN		A3

#define POWER_ON_HOLD	A4		// (==>board) keeps the power on, lower to turn off
#define POWER_BUTTON	A5		// (<==button) asserted when pressed

#define BATTERY_MONITOR	A6		// tied to RAW (9v) through 22k / 22k resistors (1/2 voltage)

#endif

//
// Battery voltage monitor is on BATTERY_MONITOR and is a resistor network
// that divides the 9v by two. This means that the max voltage is nominally
// 4.5 volts, but in actuality it is sometimes close to 5 volts because
// some batteries are well above 9v.  This routine gives voltage in the
// long integer domain times 10 where 90 is 9 volts.  Note that this routine
// can NEVER come back with 10v (100) because analogRead() comes back with
// 1023 maximum.
//
#define BATTERY_VOLTAGE	(analogRead(BATTERY_MONITOR)*5L*2L*10L/1024L)

//
// the baud rate that the local serial port will operate in - talking to the IDE terminal
//
#define LOCAL_SERIAL_BAUD	38400

#define PERSONALITYCOUNT        4 //how many personalities have been implemented
#define BOARDBRINGUPVERSION     "1.2" //which version the testing program is
#define CODEVERSION             "2.1"

//these two constants define the time before entering power saving mode and are in milliseconds
// (the second commented out versions are for debugging)

//#define LOWPOWERTIMEOUT 300000
//#define ZMODETIMEOUT 600000

#define POWEROFFHOLDDOWN 2000 //this is measured in milliseconds


// Because the switches on the ChapR are mechanical, they will generate multiple presses
// for every user press. The "debounce" is the time in milliseconds the ChapR waits after
// noticing a button press before it reports the next one.
#define DEBOUNCE 25

// defines the personalities (relates the numbers to the names)
#define PERSON_RBT_C           1
#define PERSON_NXT_G           2
#define PERSON_LABVIEW         3
#define PERSON_RIO             4

// default settings for EEPROM values that are used during board bringup.

#define DEF_NAME               "ChapRX"
#define DEF_TIMEOUT            10  // ten minutes
#define DEF_PERSON             4   // corresponds to LabView personality
#define DEF_LAG                0
#define DEF_MODE               1   // teleOp mode
#define DEF_FTCAUTOLEN         30  // (secs) defaults set for FTC
#define DEF_FTCTELELEN         90  // (secs)
#define DEF_FTCENDLEN          30  // (secs)
#define DEF_FRCAUTOLEN         15  // (secs) defaults set for FRC
#define DEF_FRCTELELEN         135 // (secs)
#define DEF_FRCENDLEN          20   // (secs)
#define DEF_MATCHMODE	       1   // matchmode is "on" by default
