ChapResearch/ChapR/ChaprSVN/Firmware/ChapR/nxt.h

//
// nxt.h
//
//   This file (and the associated nxt.cpp) supports communicating with the NXT as a
//   ChapR target device.
//   
//   The LEGO NXT device uses a communication protocol that provides control and data
//   query over both USB and Bluetooth (BT).  In fact, it is the same protocol with the
//   exception that BT comm requires an extra length field.
//
//   The protocol is broken up into two different sections.  Each has a separate
//   document dedicated for it, that is available from LEGO.
//
//	1 - System Commands
//	2 - Direct Commands
//
//   This file provides defines for most of the commands available.
//
//   When specifying a command, the first bytes specifies which type of command and
//   determines if a reply is requested:
//
//	0x00 - Direct Command, reply required
//	0x01 - System Command, replay required
//	0x02 - Replay command
//
//	0x80 - Direct Command, no reply required
//	0x81 - System Command, no reply required
// 
//   A command can have up to 64 bytes in it.  Though this must take into account the
//   lead-in command bytes.  Also, BT has further restrictions.
//
//   Command format - here is the format implied by all of the above:
//
//    
//   ,-----,-----,------,-----,------,-----
//   | LSB | MSB | type | cmd | data |...
//   '-----'-----'------'-----'------'-----
//   |           |  0      1     2     ...
//   | BT length |
//   | not used  |
//   | for USB   |
//   |  0     1     2      3     4     ....
//

//
// COMMAND TYPE (first byte)
//
#define NXT_DIR_CMD	'\x00'		// Direct command - reply required
#define NXT_SYS_CMD	'\x01'		// System command - reply required
#define NXT_REPLY_CMD	'\x02'		// Reply command
#define NXT_DIR_CMD_NR	'\x80'		// Direct command - NO REPLY
#define NXT_SYS_CMD_NR	'\x81'		// System command - NO REPLY

//
// SYSTEM COMMANDS (second byte) - preceeded by 0x01 or 0x81
//
#define NXT_SYS_OPEN_R	'\x80'		// Opens a file for reading from the NXT
#define NXT_SYS_OPEN_W	'\x81'		// Opens a file for writing to the NXT
#define NXT_SYS_READ	'\x82'		// Reads data from an open file
#define NXT_SYS_WRITE	'\x83'		// Writes data to an open file
#define NXT_SYS_CLOSE	'\x84'		// Closes a file previously opened for reading/writing
#define NXT_SYS_DELETE	'\x85'		// Delete the named file
#define NXT_SYS_FIND	'\x86'		// Finds the first file on the NXT matching a pattern
#define NXT_SYS_NEXT	'\x87'		// Finds the next file matching the previous pattern
#define NXT_SYS_VERSION	'\x88'		// Returns version of the NXT firmware running
#define NXT_SYS_OPENL_W	'\x89'		// Open Write Linear
#define NXT_SYS_OPENL_R	'\x8A'		// Open Read Linear
#define NXT_SYS_OPEND_W	'\x8B'		// Open Write Data
#define NXT_SYS_APPD_W	'\x8C'		// Open Append Data
#define NXT_SYS_BOOT	'\x97'		// Reboot the NXT
#define NXT_SYS_NAME	'\x98'		// Set the NXT name
#define NXT_SYS_INFO	'\x9B'		// Get system information
#define NXT_SYS_CLEAR	'\xA0'		// Delete user flash
#define NXT_SYS_POLL_L	'\xA1'		// Poll command length
#define NXT_SYS_POLL_C	'\xA2'		// Poll command
#define NXT_SYS_BTRST	'\xA4'		// Factory reset on the Bluetooth

//
// SYSTEM COMMAND CONSTANTS
//
#define NXT_REBOOT_MAGICSTRING  "Let's dance: SAMBA"  //string for booting NXT

//
// DIRECT COMMANDS (second byte) - preceeded by 0x00 or 0x80
//
#define NXT_DIR_START	'\x00'		// Start the named program
#define NXT_DIR_STOP	'\x01'		// Stop the named program
#define NXT_DIR_SOUND	'\x02'		// Play the named sound file
#define NXT_DIR_TONE	'\x03'		// Play the given tone
#define NXT_DIR_SET_OUT	'\x04'		// Set the given output state for motors (OUTPUT STATE)
#define NXT_DIR_SET_IN	'\x05'		// Set the given state for inputs (INPUT MODE)
#define NXT_DIR_GET_OUT	'\x06'		// Get the output states
#define NXT_DIR_GET_IN	'\x07'		// Get the input values
#define NXT_DIR_SCALE_R	'\x08'		// Reset the scaled values on input
#define NXT_DIR_SEND	'\x09'		// Send a direct message
#define NXT_DIR_MOTOR_R	'\x0A'		// Reset motor position
#define NXT_DIR_BATTERY	'\x0B'		// Get battery level
#define NXT_DIR_SOUND_X	'\x0C'		// Stop sound playback
#define NXT_DIR_KEEP	'\x0D'		// Keep Alive
#define NXT_DIR_LS_GET	'\x0E'		// Get LS status
#define NXT_DIR_LS_W	'\x0F'		// LS write
#define NXT_DIR_LS_R	'\x10'		// LS read
#define NXT_DIR_CURRENT	'\x11'		// Get current program name
#define NXT_DIR_RECV	'\x13'		// receive a direct message

//
// RESPONSE PACKAGE BYTE LOCATIONS
//
#define NXT_TYPE           0            //always 0x02 to indicate "response package"
#define NXT_RSP            1            //the command it is responding to
#define NXT_STATUS         2            //the status of the command response (see below for error messages)

//Get Program Name
#define NXT_PRGM_NAME      3            //bytes 3 through 22 are the name of the program currently running (null-terminated)
#define NXT_PRGM_NAME_SIZE 20           //the size of the program name, including null termination (and ".rxe")

//
// ERROR MESSAGES FOR DIRECT COMMANDS
//
#define NXT_ERR_NONE       '\x00'           // Success!
#define NXT_ERR_TRANS      '\x20'           // Pending communication transaction in progress
#define NXT_ERR_MBOX       '\x40'           // Specified mailbox queue is empty
#define NXT_ERR_RFAIL      '\xBD'           // Request failed (i.e. specified file not found)
#define NXT_ERR_UNKN       '\xBE'           // Unknown command opcode
#define NXT_ERR_INSANE     '\xBF'           // Insane packet
#define NXT_ERR_OOR        '\xC0'           // Data contains out-of-range values
#define NXT_ERR_CBUS       '\xDD'           // Communication bus error
#define NXT_ERR_BUFMEM     '\xDE'           // No free memory in communication buffer
#define NXT_ERR_CNINV      '\xDF'           // Specified channel/connection is not valid
#define NXT_ERR_BUSY       '\xEO'           // Specified channel/connection not configured or busy
#define NXT_ERR_NOACT      '\xEC'           // No active program
#define NXT_ERR_ILSIZE     '\xED'           // Illegal size specified
#define NXT_ERR_ILID       '\xEE'           // Illegal mailbox queue ID specified
#define NXT_ERR_ILFLD      '\xEF'           // Attempted to access invalid field of a structure
#define NXT_ERR_ILINPT     '\xF0'           // Bad input or output specified
#define NXT_ERR_NOMEM      '\xFB'           // Insufficient memory available
#define NXT_ERR_BDDARG     '\xFF'           // Bad arguments

//
// ERROR MESSAGES FOR SYSTEM COMMANDS
//
#define NXT_SYS_ERR_NONE   '\x00'           // Success
#define NXT_SYS_ERR_NOHNDS '\x81'           // No more handles
#define NXT_SYS_ERR_NOSPCE '\x82'           // No space
#define NXT_SYS_ERR_NOFILS '\x83'           // No more files
#define NXT_SYS_ERR_NOEND  '\x84'           // End of file expected
#define NXT_SYS_ERR_FILEND '\x85'           // End of file
#define NXT_SYS_ERR_NOLINE '\x86'           // Not a linear file
#define NXT_SYS_ERR_NOFILE '\x87'           // File not found
#define NXT_SYS_ERR_HNDL   '\x88'           // Handle all ready closed
#define NXT_SYS_ERR_NLNMEM '\x89'           // No linear space
#define NXT_SYS_ERR_UNKOWN '\x8A'           // Undefined error
#define NXT_SYS_ERR_BUSY   '\x8B'           // File is busy
#define NXT_SYS_ERR_NOWBUF '\x8C'           // No write buffers
#define NXT_SYS_ERR_NOAPND '\x8D'           // Append not possible
#define NXT_SYS_ERR_FILFUL '\x8E'           // File is full
#define NXT_SYS_ERR_FILEXT '\x8F'           // File exists
#define NXT_SYS_ERR_MNOFND '\x90'           // Module not found
#define NXT_SYS_ERR_OUTBND '\x91'           // Out of boundary
#define NXT_SYS_ERR_ILNAME '\x92'           // Illegal file name
#define NXT_SYS_ERR_ILHNDL '\x93'           // Illegal handle


#define NXT_GET_DEV_INFO NXT_SYS_INFO
#define NXT_REBOOT       NXT_SYS_BOOTH

extern int nxtMsgCompose(byte *output, 		// the output buffer to scribble things to - min 22 bytes
			 byte UserMode,		// the usermode value
			 byte StopPgm,		// the wait-for-start value
			 byte *USBJoystick1,	// buffers for the two joysticks
			 byte *USBJoystick2);

extern int  nxtBTMailboxMsgCompose(int,byte *,int);

extern bool nxtQueryDevice(VDIP *, int, char **, char **, long *);
extern bool  nxtBTKillCommand(BT *);
extern bool nxtGetProgramName(BT *, char*);
extern bool nxtGetChosenProgram(BT *, char*);
extern int nxtOpenFileToRead(BT *, char*, long*);
extern int nxtReadFile(BT *, char *, int, int);
extern bool nxtCloseFile(BT *, int);
extern bool nxtRunProgram(BT *, char *);
