ChapResearch/ChapR/ChaprSVN/Firmware/ChapR/gamepad.cpp

#include <Arduino.h>
#include "VDIP.h"
#include "gamepad.h"

// constructor - loads up a blank (but valid) gamepad

Gamepad::Gamepad(int _id) : translator(NULL), init(NULL), id(_id), x1(0), y1(0), x2(0), y2(0), buttons(0), tophat(0), initialized(false)
{
}

#ifdef DEBUG

void Gamepad::debugPrint(char *prefix)
{
     Serial.print(prefix);
     Serial.print(": X1:");
     Serial.print(x1);
     Serial.print(" Y1:");
     Serial.print(y1);
     Serial.print(" X2:");
     Serial.print(x2);
     Serial.print(" Y1:");
     Serial.print(y2);
     Serial.print(" TOP: ");
     Serial.print(tophat);
     Serial.println("");
}

#endif

//
// clear() - clear the data in the gamepad, setting it to the "neutral" position
//	     for all things.  Centered joysticks, unpressed buttons.
//
void Gamepad::clear()
{
     x1 = y1 = x2 = y2 = x3 = y3 = 0;
     buttons = 0;
     tophat = 0;
}

//
// update() - updates the gamepad to see if anything has changed.  If so, returns true,
//		false if nothing has changed.  If there was a change, the gamepad is
//		updated to include the new values.
//
bool Gamepad::update(VDIP *vdip)
{
     byte	data[MAXTRANSLATE];
     int	count;

     if(!initialized) {
	  initialized = true;
	  if(init != NULL) {
	       (*init)(id,vdip);	// port is 1 or 2 in this case
	  }
     }

     count = vdip->getJoystick(id-1,(char *)data);	// note, ID is either 0 or 1 (not 1 or 2)
     if(translator != NULL) {
	  return((*translator)(data,count,*this));
     }
     return(false);
}

//
// deviceUpdate() - update the internal concept of the device that is plugged into
//		    this particular gamepad.
//
void Gamepad::deviceUpdate(VDIP *vdip)
{
     unsigned short	vid, pid;
     int		type;

     initialized = false;

     // note that we ignore the type - we just match on vid/pid

     if (vdip->portConnection(id-1,&type,&vid,&pid)) {	// ID is either 0 or 1 (not 1 or 2) in VDIP
          this->type = driverLookup(vid,pid,&translator,&init);	// may come back as NULL too
     } else {
       clear();
	  translator = NULL;
	  init = NULL;
     }
}
