ChapResearch/ChapR/ChaprSVN/Arduino.save/Chapr sketchy/personality_2.cpp

//
// personality_2.cpp
//
//   Implements the personality:  LabView
//

#include <arduino.h>
#include "VDIP.h"
#include "BT.h"
#include "gamepad.h"
#include "nxt.h"
#include "personality.h"
#include "personality_2.h"
#include "robotc.h"
#include "sound.h"

#include "debug.h"

Personality_2::Personality_2() : buttonToggle(false), forceMode(false)
{
    
}

//
// Loop() - for the NXT-RobotC pesonality, a message is sent out for each
//		loop through the Arduino code.  The message is simply the
//		appropriately formatted BT message with the translation of
//		the Gamepads and inclusion of the button.
//
void Personality_2::Loop(BT *bt, int mode, bool button, Gamepad *g1, Gamepad *g2)
{
     byte	msgbuff[64];	// max size of a BT message
     int	size;

     // override the mode if we have run a program - stays there until a Kill() is called

     if(forceMode) {
	  mode = USER_MODE_TELEOP;
     }

     if (bt->connected()) {

	  // first convert the gamepad data and button to the robotC structure
	  size = robotcTranslate(msgbuff,buttonToggle,g1,g2,mode);
	  
	  // then compose a NXT mailbox message (for BT transport) with that data
	  // this routine operates within the given buffer.  Note that the
	  // mailbox used is #0.
	  size = nxtBTMailboxMsgCompose(0,msgbuff,size);

	  // then send it over BT, again, operating on the message buffer
	  (void)bt->btWrite(msgbuff,size);
     }
}

void Personality_2::Kill(BT *bt, int mode)
{
     extern sound beeper;

     if (nxtBTKillCommand(bt)){
         beeper.kill();
     }

     // always turn off forcemode when the Kill is done

     forceMode = false;
}

void Personality_2::ChangeInput(BT *bt, int mode, int device, Gamepad *old, Gamepad *gnu)
{
     // nothing happens here for this personality
}

// NOTE - this is just like the Personality_0::ChangeButton() except that the
//	  button toggles

void Personality_2::ChangeButton(BT *bt, int mode, bool button)
{
     extern sound beeper;
     char  buf[NXT_PRGM_NAME_SIZE];
     
     if (button){ //only executes if the button is in the down position
       if (nxtGetProgramName(bt, buf)){
         // program is running so the action button functions as a WFS button 
         // and is handled by the loop call of the personality
	 buttonToggle = !buttonToggle;
	 (buttonToggle && bt->connected())?beeper.beep():beeper.boop();
       } else {
           if (nxtGetChosenProgram(bt, buf) && nxtRunProgram(bt, buf)){
             beeper.start();
           } else {
             beeper.icky();
           }
	   buttonToggle = false;	// always starts as false after starting a program
	   forceMode = true;		// the mode is forced to be teleop until a kill
         }
     } else {
	  // for this personality, nothing ever happens when the button comes up
     }
}
