ChapResearch/ChapR/ChaprSVN/Arduino.save/Chapr sketchy/debug.h

//
// debug.h
//
//	Along with debug.cpp, includes routines for debugging.
//

#ifndef DEBUG_H
#define DEBUG_H

extern void dumpDataHex(byte *, int);
extern void dumpDataHex(char *label, byte *, int);

#endif DEBUG_H
