ChapResearch/ChapR/(commit log)

2013-04-17 Initial check-in of source code.
    [ArduinoBluetoothMatev13.brd, ArduinoBluetoothMatev13.sch, ProtoShield-v25.brd, ProtoShield-v25.sch, arduino_Uno_Rev3-02-TH.brd, arduino_Uno_Rev3-02-TH.sch]
2013-04-20 Added initial chaprshield
    [chaprshield.brd, chaprshield.sch]
2013-04-20 Added pin headers and started wiring.
    [chaprshield.brd, chaprshield.sch]
2013-04-23 Check-in for first operational version of the ChapR - prototype v0.1. Added blinky and sound too.
2013-04-24 Added nameTester prototype and tester programs.
2013-04-30 fixes for tophat and buttons
    [nxt.cpp]
2013-04-30 Added to-do list for hardware, software and the case (after St. Louis trip results).
2013-05-05 A new folder was added to allow for resetting the name of the ChapR. The ChapRName class was copied into this directory, though it should be the same as the other one.
    [ChapRName.cpp, ChapRName.h, Chapr.ino, NameReset.ino, nameResetTest.ino]
2013-05-06 Checked off integrating the naming into the main software and took out some of the debugging code (Serial prints).
2013-05-08 added power connector, placed holes
    [chaprshield.brd, chaprshield.sch]
2013-05-09 Added the new button class, as well as the test results from 5-9-13. Holding onto the Chapr.ino file because it may have some bugs.
    [button.h]
2013-05-16 Changed BT to have a longer delay after reset. Tested and approved lowPower mode, but working on zombie mode.
    [BT.cpp, BTCom.ino, Chapr.ino, readNameTester.ino]
2013-05-16 Added more notes on the power testing to the To-Do list. Added more functions to the zombieMode (now puts the BT module into deep sleep).
2013-05-16 First version of the ChapR board v0.2. These files were sent to Sunstone.
    [chaprshield.brd, chaprshield.sch]
2013-05-24 Made some minor edits and added the pictures of the old prototype (we can swap in pictures of the new prototype when we get it).
2013-06-23 Changes to keep vias away from bottom of BT module.
    [chaprshield.brd, chaprshield.sch]
2013-06-29 Rewrite of VDIP code to make it more robust. Addition of new VDIP file VDIPlow.cpp that implements low-level VDIP stuff. Added shutdown of VDIP to power save mode (also turned off the green LED on pi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
2013-06-30 Moved this from the Shield directory and renamed it to ChapR.
    [ArduinoBluetoothMatev13.brd, ArduinoBluetoothMatev13.sch, ProtoShield-v25.brd, ProtoShield-v25.sch, arduino_Uno_Rev3-02-TH.brd, arduino_Uno_Rev3-02-TH.sch, chapr.brd, chapr.sch]
2013-07-01 Read the NXT device info (and tried to tell the RN42 the BT ID).
2013-07-16 Intermediate version with new power-on circuit. NOT COMPLETE.
    [chapr.brd, chapr.sch]
2013-07-16 Added Serpac case
2013-07-16 New Price list
    [PriceSourceList v1.xlsx]
2013-08-24 Added the push-button "on", flipped around the phase of blinky so the light goes on immediately (during power-up) and made minor changes to button.
    [Chapr.ino, blinky.cpp, button.h]
2013-08-25 Integrated naming software into main Chapr.ino file, finished USB pairing, fixed master/slave issue for BT pairing and updated the to-do list.
    [BT.cpp, ChapRName.cpp, ChapRName.h, Chapr.ino, VDIP.cpp, nxt.cpp, nxt.h]
2013-09-07 Added firmware for flashing VDIP, as well as fixing reading from a disk.
    [ChapREEPROM.h, Chapr.ino, VDIP.cpp, VDIP.h, sound.cpp]
2013-09-11 Added instructions for VDIP programmer mod
    [FTDI Basic-v21-5V.brd, FTDI Basic-v21-5V.sch]
2013-09-12 Implemented master/slave flip for USB pairing, added a kill switch and made sure the power-off takes a full 2 seconds of holding down the button. It just works. It's great.
    [ChapREEPROM.cpp, ChapREEPROM.h, Chapr.ino, VDIP.cpp, VDIP.h, config.h, sound.h]
2013-09-12 Added the kill switch as an activity to postpone power-down and renamed sounds so that it yawns as it goes to sleep.
2013-09-18 Added procedures for quality analysis, along with a LabView personality and picture of the latest case (v0.3).
2013-09-20 Finished the board bring-up program.
2013-10-09 Added more mouser sources including transistors and switches.
    [PriceSourceList v1.xlsx]
2013-10-16 New revision with new part numbers and updated counts
    [PriceSourceList v2.xlsx]
2013-10-17 Bumped version to 1.1 - includes power saving by powering-down the portions of the Arduino that the ChapR doesn't use (like ADC). The serial port is powered down, too, during normal operation - so co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
    [Chapr.ino, config.h, power.cpp, power.h, sound.cpp, sound.h]
2013-10-17 added screws
    [PriceSourceList v2.xlsx]
2013-10-17 I renamed pictures and added marketing materials.
2013-10-20 Here are more marketing materials, including the updated flyer, general marketing ideas and the FTC presentation.
2013-10-22 Added the picture of the case with the new label.
2013-10-24 normalized the use of reset() - necessary for RN-42 ver 6.15
    [BT.cpp]
2013-10-25 Updated the board bring-up to turn off the BT LED before testing the power LED.
2013-10-26 Fixed the bug with the top part of tophat. Now on version 1.2. Also versioned the board testing program.
    [config.h, gamepad.cpp, robotc.cpp]
2013-11-16 Fixed the -128 problem in robotc.cpp. Added the remote teleOp start functionality (not including the sounds or personality 2). Debounced the button in button.cpp. Fixed any any references to the butt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
    [BT.cpp, BT.h, ChapREEPROM.cpp, Chapr.ino, VDIP.cpp, VDIPSPI.cpp, button.h, config.h]
2013-11-18 Implemented the start() sound for when remote teleOp start and icky() if something goes wrong. The kill noise (for when a program is stopped) and the up and down tones of the button are written, but 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
    [personality_0.cpp, sound.cpp, sound.h]
2013-11-18 Finished the defines for the error messages.
    [nxt.cpp, nxt.h]
2013-11-20 STILL HAS A BUG!!!
    [Chapr.ino, nxt.cpp, nxt.h, personality.h, personality_0.cpp, personality_0.h, personality_1.cpp, personality_2.cpp]
2013-11-21 - changed default mode to AUTONOMOUS ChapR.ino - when programs start via FTCConfig.txt, mode is forced to be TELEOP - removed debugging code for starting programs - updated personality 2 (LabView) to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
    [Chapr.ino, config.h, debug.cpp, nxt.cpp, nxt.h, personality_0.cpp, personality_0.h, personality_1.cpp]
2013-11-21 Made a VDIP flashing point in board bringup.
2013-11-22 Turned on low power mode
2013-11-26 - Added battery voltage monitor - less than 6.5 volts causes power LED rapid flash - increase VDIP flash delay to 20 seconds - turned off low power operation mode - needed the ADC on
2013-12-01 The current release candidate for v1.3. Made it so that the ChapR wouldn't beep/boop when going into pairing mode.
2013-12-03 - flushed extra data from BT during board bring-up so it can be done again (BT.cpp) - fixed (and controlled) the VDIP reflashing process during board bring-up - bumped board bring-up to v1.2 - added 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
    [BT.cpp, ChapREEPROM.cpp, VDIP.h, config.h]
2013-12-03 Added case labels for 1.0 and 1.1
2013-12-04 Fixed the bug with the kill switch not working the first time after pairing.
    [ChapREEPROM.cpp, ChapREEPROM.h, Chapr.ino, VDIP.cpp]
2013-12-06 The updated version of the flyer for the Vandegrift competition. It now includes the kill switch and remote tele-Op start.
2013-12-12 Added new parts for batt mon, and included recent inventory
    [PriceSourceList v3.xlsx]
2013-12-12 Updated the price list and created a "release" version for the rest of the world (without inventory)
    [PriceSourceList v3 Release.xlsx, PriceSourceList v3.xlsx]
2013-12-17 Added power monitoring resistors. Fixed R15 label. Bumped to v1.1
    [chapr.brd, chapr.sch]
2014-01-01 I updated the Construction Instructions v1.docx, added a Support Log.txt to keep track of all the times we deal with customer support, and added some pictures.
2014-01-01 Added the last few changes based on how production went (though the speaker, 9V snap and LED fixing is still missing).
2014-01-09 Added lag data and graph
    [LagResearch v1.xlsx]
2014-01-11 - added BT addressFilter for normalizing BT addresses for the RN-42 - added ability to pair to "targetID.txt" file specified address - started "target.txt" implementation that intends to pair to a na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
2014-01-11 Updated the instructions (added the 9V snap and speaker instructions).
2014-02-19 Added the inventory, Presentation for Patent Signing.pptx and a picture of all the places the ChapR has been shipped too.
    [PriceSourceList v3.xlsx]
2014-02-19 Added the Dining Room Soldering.JPG picture.
2014-03-31 Added all of the LabView code for using the ChapR with the cRIO. Currently working, though without any added features.
2014-04-17 Removed FIRST logos (worried that they didn't comply with FIRST rules for use) and fixed/moved some things. Going to print.
2014-04-20 Finished all reading and writing to EEPROM. There are some very basic checks for accuracy in files, but not many. The ChapR will beep strangely when the red button is pressed, because I haven't finis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
2014-04-20 Added a picture I found attached to the progress report from Vandegrift.
2014-04-23 Final version for printing. Had problems with the Lexmark laser, so I had to remove the blue in the Chap Robotics box.
2014-04-29 Only the necessary files from Arduino, plus refactoring of ChapREEPROM to settings. The state of the code itself is iffy however.
2014-04-29 First version of new settings reading from user. First version of drivers for joysticks.
2014-05-06 consolidated the 2 v4.77 special changes. Note that to drive a 4.77 board, you need to set an appropriate define in BT.cpp
2014-05-06 Added/finished Xbox360 support, including LEDs. Started PS3 support, though it's not done. Added initialize routine in driver database.
2014-05-06 Cleared conflicted state. Includes reading up to 8 logical USB devices to catch 2 xbox controllers. Includes feedback for VDIP-noticed changes for use in updating gamepads.
2014-05-06 Added code to allow return of true/false if a deviceUpdate caused a change - which is used for updating gamepad structure. Added scan of 8 logical devices to catch 2 Xbox360 controllers, each of whic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
2014-05-06 Forgot to mark EEPROM as initialized once initialized. Fixed!
    [settings.cpp]
2014-05-09 Changed settings.cpp to cache all the values instead of reading and writing EEPROM. Added personality.cpp to implement matchMode at the personality level. Also a minor typo fix in the debug class and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
    [ChapR.ino, VDIP.cpp, cRIO.cpp, cRIO.h, config.h, debug.cpp, personality.cpp, personality.h]
2014-05-15 Added the code to set the 6.15 version of RN42 to do pin-mode connections (fixes the USB-pairing problem)
    [BT.cpp]
2014-05-17 Fixed match cycling for personality_2.cpp, though pausing/playing doesn't work. Also, personality.cpp has not been tested with RobotC and cRIO personalities (though they haven't been tested, period).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
    [ChapR.ino, nxt.h, personality.cpp, personality.h, personality_2.cpp, settings.cpp]
2014-05-17 Reorganized the folders, added the separate board bring up stuff, and added a few comments to the personality code.
    [PriceSourceList v1.xlsx, PriceSourceList v2.xlsx, PriceSourceList v3 Release.xlsx, PriceSourceList v3.xlsx]
2014-05-17 fixed the defaults to be the RIGHT ONES from config.h - as well as added ENDLEN to the defaults.
    [ChapR.ino, config.h]
2014-05-17 added a couple externals
2014-05-20 removed some text, and put it in board bring-up
2014-05-20 First real version of external board bring-up. works for "existing" boards - want to test it on real "new" boards.
2014-05-20 Fixed the match cycling to be more efficient, simple and readable. The functionality of matchModeIsEnabled is completely separate from the normal functionality.
    [personality.cpp, personality.h, personality_2.cpp, settings.cpp, sound.cpp]
2014-05-20 One more fix to remove mode.
    [personality_0.cpp]
2014-05-20 Removed the zombie mode that we no longer used. Note that the code is in a NOTDEF in VDIP.cpp and BT.cpp so some future person can see how to enter zombie mode if they want.
    [BT.cpp, ChapR.ino, VDIP.cpp]
2014-06-06 Fixed the button translating in the ChapR.vi. Also made a small change to ChapR Test for debugging matchMode.
2014-06-06 Updated to remove the button from the Loop() call.
2014-06-07 Updated the Loop() function to NOT have the button. It doesn't affect this personality in any way.
    [personality_1.cpp, personality_1.h]
2014-06-07 Removed the button from the Loop() function and recoded appropriately to use the "enabled" member of the personality object.
2014-06-10 In ChapR.ino and config.h, I specified that the match config defaults are for FTC. Fixed analog inputs in cRIO.cpp (swapped so it's now big endian). Also fixed the analog and digital input functional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
    [ChapR.ino, VDIP.cpp, cRIO.cpp, cRIO.h, config.h, personality_0.cpp, personality_2.cpp, personality_2.h]
2014-06-10 Combined the code for personalities 0 and 2 to save code space. 2 is just like 0 except that the action button toggles enabled.
2014-08-26 Added a ProMini version without the 6 pin header. The silk screen is still there so that it is easy to appropriately orient the ProMini, but this version doesn't cause the holes to be drilled, provid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
2014-08-26 Used the new ProMini without the top 6 pins. Created AutoRouter and DesignRule files for repeatable routing. Added clearance between vias and pads so we don't have to post-process the routes.
    [chapr.brd, chapr.sch]
2014-10-19 Added the ChapR Soldering Station List.doc
2014-11-05 added LATEST (and hopefully last) endcap, with ALL relevant files
    [End Cap.STL, Part1.SLDPRT]
2015-01-04 Ben's first cut at Eagle versions of the BeatBoard MXP board.
    [colororgan.brd, colororgan.sch]
2015-01-04 A few changes for ease of reading. added 5v to the upward bound MXP connector.
    [colororgan.brd, colororgan.sch]
2015-01-06 It the Solo now works like it used to on the new board. It can detect different game modes now.
2015-01-20 changed case of arduino.h to be compatible with linux - and added Makefile
2015-01-20 fixed wrong case vdip.h
    [nxt.cpp]
2015-01-20 added default in switch to quite compiler - an actually saved 14 bytes
2015-01-20 Made minor changes to fix the unsigned vs signed compiler warnings
    [BT.cpp, ChapR.ino, button.h, settings.cpp]
2015-01-21 fixed a few more compiler warnings
    [drivers.cpp, nxt.cpp]
2015-01-22 added wiring diagram
2015-01-22 A couple fixes to personality 0/2, and a space rewrite of personality 1.
    [matchmode.cpp, personality_0.cpp, personality_1.cpp, personality_1.h]
2015-01-23 Replaced the Serial.print((double)) with a custom routine - saving 346 bytes total. Added setting the default matchmode in config.h and settings.cpp/settings.h/Chapr.ino. Bumped up the version from 1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
    [ChapR.ino, config.h, settings.cpp, settings.h]
2015-01-25 Finished the Wiring Diagram.pptx
2015-02-02 Added in boardBringUp and made memory optimization changes.
2015-02-03 Made minor edits to fix the bug about the ChapR not disabled when disconnected.
    [matchmode.cpp, matchmode.h, personality_0.cpp, personality_3.cpp]
2015-02-04 Adjusted the wires that go to the analog pins on the Arduino.
2015-02-05 Committing the final changes to 2015 St. Louis Presentation Application.docx and added the 1st Board of Advisers Meeting.pptx
2015-02-08 Added the Solidworks model of the RN42 tester fixture. Includes the STL file that can be used to print it out on a 3D printer. Note that the holes may need to be fine tuned - the current fixture was 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
    [Fixture.SLDPRT, Fixture.STL]
2015-02-08 Added the Arduino code for running the RN42 tester.
2015-02-10 Added "!" starts up board bringup.
2015-02-10 Added RN42 test program that can cause an RN42 to print out version number on a completed ChapR - though you have to have a logic analyzer to see it!
2015-02-12 A bug in new magic new is still there. When played, the arduino senses a fruit being touched before you can touch the correct fruit.
2015-02-12 Done: analog triggers of Xbox 360 always send 0
    FTC personalities set by USB use FTC defaults for matchmode (same for FRC)
    *NOTE: this does NOT occur for the setting by Serial because it's so easy to set the values yourself, but I can change that if you think it's worth it
    matchmode noises (though I use beep and boop because there isn't space for new ones)
    To Do:
    auto enabled setting for roboRIO (asking Joe for the value)
    board bring up (checking VDIP and RN42 version)
    test drivers for Xbox and Attack3
    document everything (release notes would be awesome)
    get rid of analog/digital inputs
    [VDIP.cpp, config.h, drivers.cpp, personality_3.cpp, sound.cpp]
2015-02-12 edited the sound files
    [ChapX end cap (2).SLDPRT, ChapX end cap.SLDPRT, ChapX end cap_new.SLDPRT, ChapX end cap_new.STL, ChapX end cap_new_new.SLDPRT, ChapX end cap_new_stl.STL]
2015-02-12 put contents of defaults onto the svn
    [ChapX end cap (2).SLDPRT, ChapX end cap.SLDPRT, ChapX end cap_new.SLDPRT, ChapX end cap_new.STL, ChapX end cap_new_new.SLDPRT, ChapX end cap_new_stl.STL]
2015-02-13 Fixed a typo in ChapR.ino, fixed the auto define and fiddled around with debugging. That one GameStop controller that stopped working is now mysteriously working?
    [ChapR.ino, RIO.h, VDIP.cpp, VDIP.h]
2015-02-14 Potentially fixed a bug in VDIP.cpp, by changing the flagging loop to have 8 instead of 2 cycles. Got rid of some print lines in drivers.cpp.
    [VDIP.cpp, drivers.cpp]
2015-02-15 Added a print line to show where I want to call the clear() function in gamepad.cpp.
2015-02-16 Changed the i=8 to i=2 in the port cycling loop thing of VDIP.cpp. It may be fixed in another revision, but it was a bug we introduced when trying to fix the VDIP stuff.
    [VDIP.cpp]
2015-02-16 Took out digital and analog inputs, saving 3,000 bytes. However, this version may not work and we may want the ChapR to send this stuff for cRIO version, so they are probably going back in.
    [ChapR.ino, RIO.cpp, settings.cpp, settings.h]
2015-02-17 Match mode is now on by default. Also, I fixed some minor bugs in the USB flashing of mConfig.txt and canMMode.txt. The Serial monitor flashing of the digital and analog inputs has been commented out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
    [RIO.h, VDIP.cpp, config.h, drivers.cpp, personality_3.cpp, settings.cpp, settings.h]
2015-02-17 Changed the method by which USB port changes are "noticed." A new routine in VDIP.cpp uses the QP command to determine if something has changed on the USB ports. If so, then the longer deviceUpdate()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
2015-02-22 Fixed some minor bugs in match mode (timing, release of button).
    [config.h, matchmode.cpp, matchmode.h, personality_0.cpp, personality_3.cpp]
2015-03-02 Re-added the FMV command for the VDIP (version check). It was removed when the board bring-up was removed. Also fixed a latent bug with closing VDIP files, which would only occur with filenames that 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
    [VDIP.cpp]
2015-03-02 Added a watchdog timer that will power-down the ChapR if the code gets stuck somewhere. this was done in response to potential problems when bringing up joysticks...particularly with misbehaving joys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
    [ChapR.ino, VDIP.cpp, power.cpp, power.h, watchdog.cpp, watchdog.h]
2015-04-01 Added PUNCH template. That is, you don't DRILL with this template, you punch so you can drill after removing the template.
    [template v1.SLDPRT]
2015-07-19 Take 2 of adding sloth stuff in order to transfer to my Windows machine
2015-07-22 There have been minor changes to the RIO code in order to get FRC compatibility. However, the whole thing with the analog and digital inputs is driving me crazy. Therefore I included all of it, to pr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
    [ChapR.ino, RIO.cpp, RIO.h, VDIP.cpp, gamepad.cpp, gamepad.h, personality_3.cpp, settings.cpp]
2015-10-10 Changed version to v.2 and took out some Serial print lines within the VDIP code.
2015-10-20 Deleted the unneccessary promotional materials for the ChapR. They have been moved to the Google Drive.
2015-10-20 Moved files to google drive and cleaned up Chaprd.c Chaprd.c is working except for mysterious lag and joystick issue
    [colororgan.brd, colororgan.sch]
2015-10-31 Deleted ChapX Folder
    These files have all been moved to a separate repository.
    [ChapX end cap (2).SLDPRT, ChapX end cap.SLDPRT, ChapX end cap_new.SLDPRT, ChapX end cap_new.STL, ChapX end cap_new_new.SLDPRT, ChapX end cap_new_stl.STL]
2015-11-11 Another stage of somewhat working.
2015-11-19 Added last fixes to the ChapR 2.0 code
    Added the kill noise for the red button; caused the black button to kill
    programs
    [matchmode.cpp]
2016-01-08 Quick Clean-Up
    Moved some files to internal Google Drive folder.
    [End Cap.STL, Fixture.SLDPRT, Fixture.STL, Part1.SLDPRT, PriceSourceList v1.xlsx, PriceSourceList v2.xlsx, PriceSourceList v3 Release.xlsx, PriceSourceList v3.xlsx]
2016-07-20 Experimental Code to Add Compatibility for KC4134
    Currently the KC4134 doesn't respond (though it works beautifully
    through PuTTY)
    [VDIP.cpp, VDIP.h]
2016-08-23 Updated the configUSBDongle.c to have longer waits between prints and more user-friendly messages
2016-08-24 Updated Case Label
    The label now includes the patent number and CR logo, along with a
    version number of 2.0
2016-08-24 Adjusted to Work with Printer
    The labels are now further from the edges and the appropriate size for a
    standard sheet of paper. Note that the "original size" option should
    still be selected, as the printer may try to shrink the labels.
